timbslr/8-Bit-Breadboard-Computer/README.md

All the information and documentation about this project is currently provided via [GitHub Pages](https://timbslr.github.io/8-Bit-Breadboard-Computer/). A Readme file will be created when the project is finished.

Image of the 8-Bit Breadboard Computer from the side
