timbslr/8-Bit-Breadboard-Computer/docs/hardware-overview.md

---
title: Hardware Overview
layout: default
nav_order: 3
---

7-Segment Display schematic
