timbslr/8-Bit-Breadboard-Computer/docs/pages/hardware-overview.md

---
title: Hardware Overview
layout: default
permalink: /hardware-overview
nav_order: 3
---

## Hardware Overview

<br>

7-Segment Display schematic
