timbslr/8-Bit-Breadboard-Computer/docs/pages/modules/serial-interface.md

---
title: Serial Interface
layout: default
nav_order: 15
permalink: /modules/serial-interface
parent: Modules
---

<script type="module" src="{{ site.baseurl }}/dist/PartList.js"></script>

## Serial Interface

<part-list src="{{ site.baseurl }}/resources/PartLists/Serial Interface.csv"></part-list>

### Schematic &ndash; Receiver

<br>
Serial Interface Receiver schematic

<br>
<br>
<br>
### Schematic &ndash; Transmitter

<br>
Serial Interface Transmitter schematic
