timbslr/8-Bit-Breadboard-Computer/docs/pages/modules/memory.md

---
title: Memory
layout: default
nav_order: 12
permalink: /modules/memory
parent: Modules
---

<script type="module" src="{{ site.baseurl }}/dist/PartList.js"></script>

## Memory

<br>
<part-list src="{{ site.baseurl }}/resources/PartLists/Memory.csv"></part-list>
<br>

### Schematic

Memory schematic
