timbslr/8-Bit-Breadboard-Computer/docs/pages/modules/program-counter.md

---
title: Program Counter (PC)
layout: default
nav_order: 13
permalink: /modules/program-counter
parent: Modules
---

<script type="module" src="{{ site.baseurl }}/dist/PartList.js"></script>

## Program Counter (PC)

The Program Counter is a 16-bit register that holds the address for the next instruction. <br>
Every time an opcode or operand is fetched, the program counter is incremented in order to reference the next opcode or operand in memory.

It is also possible to load the program counter with values from the bus, which allows jumps (direct or conditional) to other memory locations.
<br>
<part-list src="{{ site.baseurl }}/resources/PartLists/PC.csv"></part-list>
<br>

### Schematic

Program-Counter schematic
