timbslr/8-Bit-Breadboard-Computer/Schematics/Reset.pdf

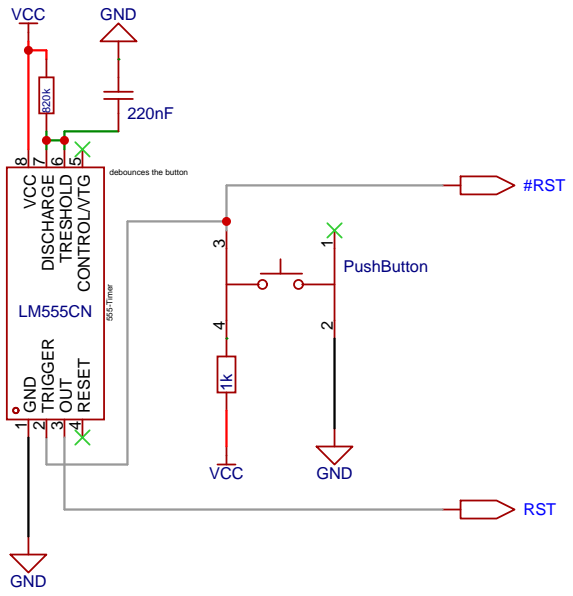
[picture p1: figure]
PushButton; VCC; GND; #RST; TRIGGER; OUT; RESET; 4 CONTROL/VTG; 5 TRESHOLD; 6 DISCHARGE; 7 VCC; GND ⁸²⁰k; 555-Timer; RST; debounces the button
