timbslr/8-Bit-Breadboard-Computer/Schematics/Y-Register.pdf

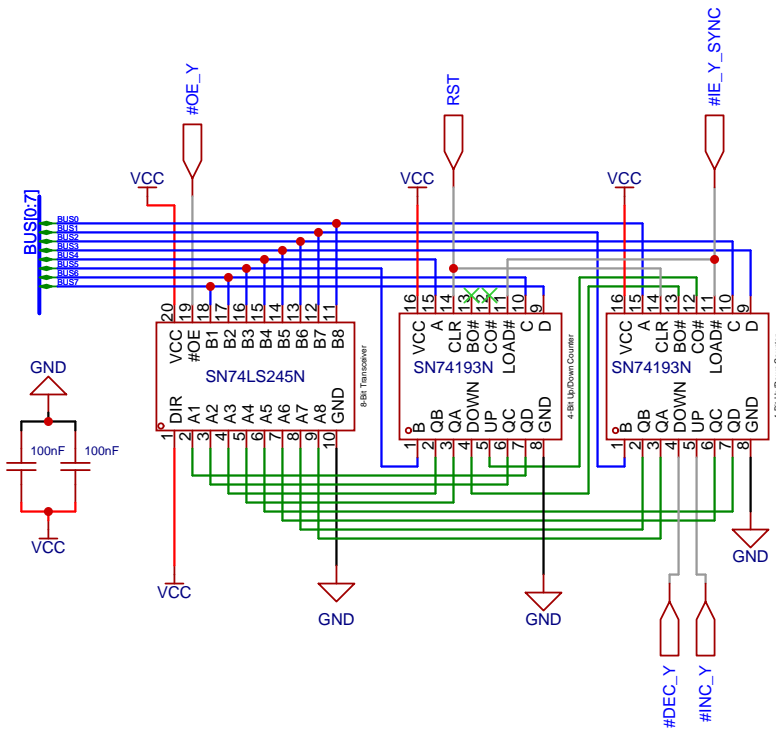
[picture p2: figure]
DIR; VCC; BUS[0:7]; GND; 8-Bit Transceiver; BUS0 BUS1 BUS2; BUS4 BUS5 BUS6 BUS7; DOWN; C 10 LOAD# 11 CO# 12 BO# 13 CLR 14; A 15 VCC 16; 4-Bit Up/Down Counter; RST; BUS3; #DEC_Y; #INC_Y #IE_Y_SYNC

GND 10 B8 11 B7 12 B6 13 B5 14 B4 15 B3 16 B2 17 B1 18 #OE 19 VCC 20

### 4-Bit Up/Down Counter
