timbslr/8-Bit-Breadboard-Computer/Schematics/Clock.pdf

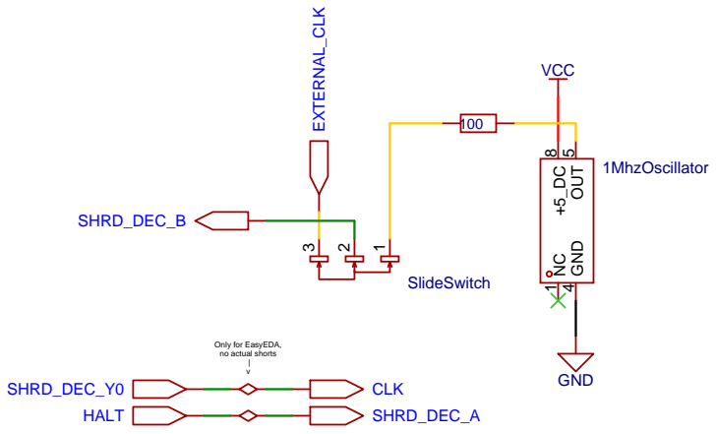
[picture p3: figure]
SHRD_DEC_A; SHRD_DEC_B; SHRD_DEC_Y0; SlideSwitch; EXTERNAL_CLK; GND; 4 OUT; 1MhzOscillator; VCC; HALT; CLK; Only for EasyEDA, no actual shorts | v
