timbslr/8-Bit-Breadboard-Computer/Schematics/LCD.pdf

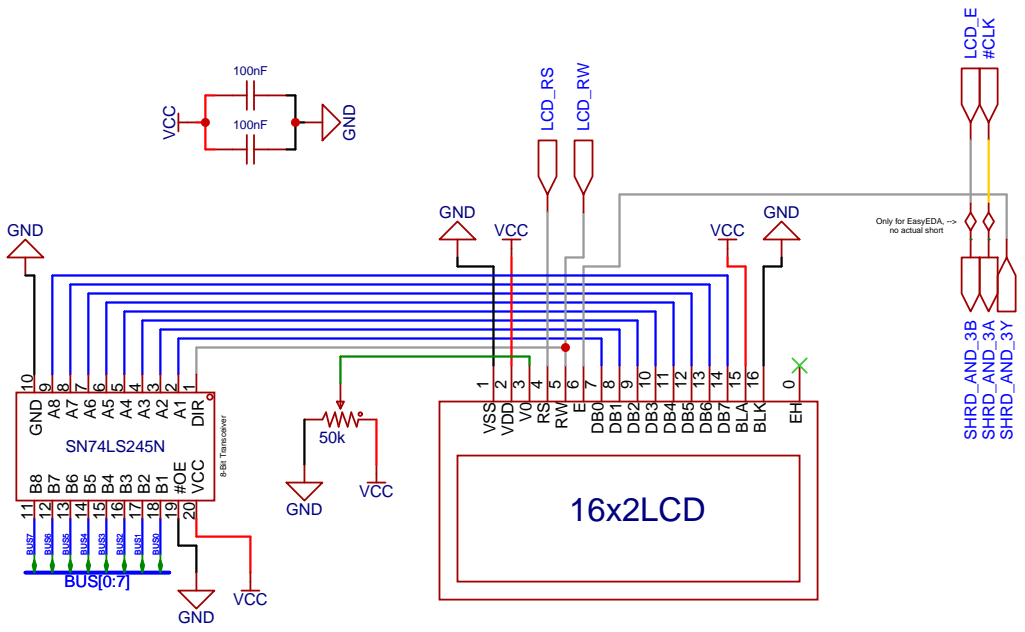
[picture p4: figure]
3 VDD; 2 VSS; 16x2LCD; VCC; GND; GND LCD_RS; LCD_RW; LCD_E #CLK; 8-Bit Transceiver; BUS[0:7]; BUS7; BUS6; BUS5; BUS4; BUS3; BUS2; BUS1; BUS0; GNDDIR; 9 GND 10 B8 11 B7 12; VCC 20; SHRD_AND_3B; SHRD_AND_3A; SHRD_AND_3Y; Only for EasyEDA, --> no actual short

BLK 16 BLA 15 DB7 14 DB6 13 DB5 12 DB4 11 DB3 10 DB2
