timbslr/8-Bit-Breadboard-Computer/docs/control-bits.md

---
title: Control Bits
layout: default
nav_order: 5
---

Each module (Registers, ALU, memory, ...) has multiple input bits that control the function of the module: Whether it loads data from the bus, outputs data to the bus, resets the module, which operation it should compute, etc. The name, abbreviation in the schematic and the description of each control bit is listed in the following table:

{: .note }
s stands for synchronous, a for asynchronous

{: #template-table}

| Abbreviation | Name | s/a | Description |
| :--- | :--- | :---: | :--- |
| Loading... | Loading... | Loading... | Loading...  |

<script type="module" src="./scripts/loadControlBits.js">
