timbslr/8-Bit-Breadboard-Computer/docs/pages/modules/a-register.md

---
title: A-Register
layout: default
nav_order: 2
permalink: /modules/a-register
parent: Modules
---

<script type="module" src="{{ site.baseurl }}/dist/PartList.js"></script>

## A-Register

The A-Register is a general-purpose 8-bit register and is built the same as the B-Register. <br>
It uses two 4-bit register chips (SN74LS173AN) and a single 8-bit bus transceiver (SN74LS245N), which controls outputting data to the bus. <br>
Technically, the 4-bit register chips even have a three-state output, so an extra 8-bit bus transceiver wouldn't be necessary. But always enabling the output of the registers and controlling the output to the bus with the bus transceiver allows me to hook up LED's to the registers output and thus displaying their contents permanently, not only on outputting to the bus. <br>

An asynchronous input provides the ability to reset the registers to zero, the CLK-input provides a synchronization for loading data from the bus (on the rising CLK edge). On the other hand, outputting data from the register to the bus is asynchronous, as the bus transceiver outputs data immediately after it's Output Enable signal goes low. <br>

The A-Register's specialty is that it is the first operand of the ALU, which means whenever you want to computer something with the ALU, no matter if it's a unary or binary operation, you have to store the first operands value in this register.

{: .warning}
Be careful when storing values into the A-Register as its contents may be overwritten by some instructions. If you store values here, ensure they aren’t overwritten unexpectedly, or store them in the safe B-, C-, X- or Y-Register.
<br>
<part-list src="{{ site.baseurl }}/resources/PartLists/A-Register.csv"></part-list>

### Schematic

<br>
A-Register schematic
