timbslr/8-Bit-Breadboard-Computer/docs/modules/clock.md

---
title: Clock
layout: default
nav_order: 6
parent: Modules
---

<script type="module" src="../scripts/PartsList.js"></script>

## Clock

<br>
<parts-list src="../resources/BOMs/Clock.csv"></parts-list>

### Schematic

<br>
Clock schematic
