timbslr/8-Bit-Breadboard-Computer/docs/modules/controller.md

---
title: Controller
layout: default
nav_order: 7
parent: Modules
---

<script type="module" src="../scripts/PartsList.js"></script>

## Controller

<br>
<parts-list src="../resources/BOMs/Controller.csv"></parts-list>

### Schematic

<br>
Controller schematic
