timbslr/8-Bit-Breadboard-Computer/docs/modules/flags-register.md

---
title: Flags-Register
layout: default
nav_order: 8
parent: Modules
---

<script type="module" src="../scripts/PartsList.js"></script>

## Flags-Register

<br>
<parts-list src="../resources/BOMs/Flags-Register.csv"></parts-list>

### Schematic

<br>
Flags-Register schematic
