timbslr/8-Bit-Breadboard-Computer/docs/modules/liquid-crystal-display.md

---
title: Liquid-Crystal-Display (LCD)
layout: default
nav_order: 10
parent: Modules
---

<script type="module" src="../scripts/PartsList.js"></script>

## Liquid-Crystal-Display (LCD)

<br>
<parts-list src="../resources/BOMs/LCD.csv"></parts-list>
<br>

### Schematic

LCD schematic
