timbslr/8-Bit-Breadboard-Computer/docs/modules/memory.md

---
title: Memory
layout: default
nav_order: 11
parent: Modules
---

<script type="module" src="../scripts/PartsList.js"></script>

## Memory

<br>
<parts-list src="../resources/BOMs/Memory.csv"></parts-list>
<br>

### Schematic

Memory schematic
