timbslr/8-Bit-Breadboard-Computer/docs/pages/parts-list.md

---
title: Parts List
layout: default
permalink: /parts-list
nav_order: 7
---

<link rel="stylesheet" href="{{ site.baseurl }}/styles/switch.css">
<script type="module" src="{{ site.baseurl }}/dist/PartList.js"></script>

---

<div class="toggle-switch-container">
  <label>Show the origins of the parts</label>
  <label class="switch small">
    <input type="checkbox" id="toggle-switch" checked>
    <span class="slider round"></span>
  </label>
</div>

---

<part-list src="ALL"></part-list>

<script>
  const checkbox = document.getElementById("toggle-switch");

  checkbox.addEventListener("change", () => {
    const cells = document.querySelectorAll(".part-list-table-col2");
    cells.forEach(cell => {
      cell.classList.toggle("hidden", !checkbox.checked);
    });
  });
</script>

<style>
  .hidden {
    display: none;
  }

  .toggle-switch-container {
    display: flex;
    justify-content: space-between;
  }

  .main-content ul > li::before {
    content: "▹";
  }
</style>
