timbslr/8-Bit-Breadboard-Computer/docs/resources/PartLists/SP.csv

Quantity | Name
2 | 5.1kΩ Resistor
1 | 74LS123 (Dual Monostable Mulivibrator)
2 | 74LS245 (8-Bit Transceiver)
2 | 82pF Capacitor
2 | 100nF Capacitor
4 | 74193 (4-Bit Up/Down Counter)
