timbslr/8-Bit-Breadboard-Computer/docs/resources/PartLists/General.csv

Quantity | Name
14 | Breadboard
2 | 4x LED Label Plate
12 | 8x LED Label Plate
1 | 16x LED Label Plate
56 | Red LED
50 | Green LED
8 | Yellow LED
8 | Blue LED
64 | 470Ω Resistor
50 | 2.2kΩ Resistor
8 | 680Ω Resistor
1 | 28x ZIF-Socket
8 | 1kΩ Resistor
70 | Meters of 22AWG Wire (approx.)
