timbslr/8-Bit-Breadboard-Computer/docs/resources/PartLists/Controller.csv

Quantity | Name
10 | 1kΩ Resistor
1 | 2.7kΩ Resistor
4 | 28C64 (8KiB EEPROM)
1 | 74LS32 (Quad 2-Input OR)
1 | 74LS86 (Quad 2-Input XOR)
1 | 74LS161 (4-Bit Binary Counter)
1 | 74LS173 (4-Bit Register)
2 | 100nF Capacitor
12 | 100pF Capacitor
1 | 330Ω Resistor
1 | 74138 (8 Line Decoder)
1 | 74151 (8-Line Multiplexer)
2 | 74154 (16-Line Decoder)
