timbslr/8-Bit-Breadboard-Computer/docs/resources/PartLists/Reset.csv

Quantity | Name
1 | 1kΩ Resistor
1 | 220nF Capacitor
1 | 820kΩ Resistor
1 | LM555CN (555-Timer)
1 | Push Button
