timbslr/8-Bit-Breadboard-Computer/docs/resources/PartLists/X-Register.csv

Quantity | Name
2 | 5.1kΩ Resistor
1 | 74LS123 (Dual Monostable Mulivibrator)
1 | 74LS245 (8-Bit Transceiver)
2 | 82pF Capacitor
2 | 100nF Capacitor
2 | 74193 (4-Bit Up/Down Counter)
