timbslr/8-Bit-Breadboard-Computer/docs/resources/PartLists/Y-Register.csv

Quantity | Name
1 | 74LS245 (8-Bit Transceiver)
2 | 100nF Capacitor
2 | 74193 (4-Bit Up/Down Counter)
