timbslr/8-Bit-Breadboard-Computer/docs/resources/PartLists/Serial Interface.csv

Quantity | Name
2 | 1N4148 Diode
2 | 1nF Capacitor
1 | 6.8kΩ Resistor
3 | 10kΩ Resistor
1 | 12kΩ Resistor
1 | 15kΩ Resistor
1 | 74LS02 (Quad 2-Input NOR)
1 | 74LS04 (Hex NOT-Gate)
1 | 74LS08 (Quad 2-Input AND)
1 | 74LS32 (Quad 2-Input OR)
1 | 74LS123 (Dual Monostable Mulivibrator)
1 | 74LS161 (4-Bit Binary Counter)
1 | 74LS164 (8-Bit SIPO Shift-Register)
1 | 74LS173 (4-Bit Register)
1 | 74LS245 (8-Bit Transceiver)
6 | 100nF Capacitor
1 | 100pF Capacitor
1 | 7474 (Dual D-Flip-Flops)
1 | 74153 (Dual 4-Input Multiplexer)
1 | 74165 (8-Bit PISO Shift-Register)
2 | LM555CN (555-Timer)
