timbslr/8-Bit-Breadboard-Computer/docs/resources/PartLists/7-Segment Display.csv

Quantity | Name
1 | 1kΩ Resistor
3 | 10nF Capacitor
1 | 28C16 (2KiB EEPROM)
1 | 74LS107 (Dual JK-Flip-Flop)
1 | 74LS139 (Dual 2 to 4 Line Decoder)
2 | 74LS173 (4-Bit Register)
1 | 100kΩ Resistor
2 | 100nF Capacitor
1 | KYX-5461AS (4x7-Segment Display)
2 | LM555CN (555-Timer)
