timbslr/8-Bit-Breadboard-Computer/docs/resources/PartLists/Clock.csv

Quantity | Name
1 | 1Mhz Oscillator
1 | 3-Pin Slide Switch
1 | 100Ω Resistor
