timbslr/8-Bit-Breadboard-Computer/docs/resources/PartLists/ALU.csv

Quantity | Name
2 | 28C16 (2KiB EEPROM)
1 | 74LS00 (Quad 2-Input NAND)
1 | 74LS02 (Quad 2-Input NOR)
1 | 74LS08 (Quad 2-Input AND)
2 | 74LS86 (Quad 2-Input XOR)
4 | 74LS157 (Quad 2-Line Multiplexer)
1 | 74LS245 (8-Bit Transceiver)
2 | 74LS283 (4-Bit Adder)
2 | 100nF Capacitor
