timbslr/8-Bit-Breadboard-Computer/docs/resources/PartLists/C-Register.csv

Quantity | Name
2 | 74LS173 (4-Bit Register)
1 | 74LS245 (8-Bit Transceiver)
2 | 100nF Capacitor
