timbslr/8-Bit-Breadboard-Computer/docs/resources/PartLists/LCD.csv

Quantity | Name
1 | 16x2 LCD
1 | 50kΩ Potentiometer
1 | 74LS245 (8-Bit Transceiver)
2 | 100nF Capacitor
