timbslr/8-Bit-Breadboard-Computer/docs/resources/PartLists/Memory.csv

Quantity | Name
1 | 28C256 (32KiB EEPROM)
1 | 74LS04 (Hex NOT-Gate)
1 | 74LS245 (8-Bit Transceiver)
2 | 100nF Capacitor
1 | U62256 (32KiB SRAM)
