timbslr/8-Bit-Breadboard-Computer/docs/resources/PartLists/PC.csv

Quantity | Name
4 | 74LS161 (4-Bit Binary Counter)
2 | 74LS245 (8-Bit Transceiver)
2 | 100nF Capacitor
