timbslr/8-Bit-Breadboard-Computer/docs/resources/PartLists/Flags-Register.csv

Quantity | Name
1 | 74LS173 (4-Bit Register)
2 | 100nF Capacitor
1 | 74126 (4-Bit Bus Buffer)
