timbslr/8-Bit-Breadboard-Computer/docs/resources/PartLists/MAR.csv

Quantity | Name
4 | 74LS173 (4-Bit Register)
2 | 100nF Capacitor
