timbslr/8-Bit-Breadboard-Computer/docs/parts-list.md

---
title: Parts List
layout: default
nav_order: 6
---

<script type="module" src="./scripts/PartsList.js"></script>

Here is a complete list of all the parts needed for building this project:

<parts-list src="ALL"></parts-list>
