timbslr/8-Bit-Breadboard-Computer/docs/pages/instruction-set/details.md

---
title: Instruction Details
layout: default
permalink: /instruction-set/details
nav_exclude: true
---

:point_right: Click to switch representation:

[Instruction Set Overview](./overview){: .btn .btn-outline}
[Opcode Matrix](./opcode-matrix){: .btn .btn-outline}
[Instruction Details](./details){: .btn .btn-green}

---

<style>
  .header {
    font-weight: 800;
  }

  .description {
    color: #646464;
  }

  .highlightedHeader {
    display: inline;
    background-color: yellow;
    transition: background-color 0.5s ease-out;
  }

  h1, h2, h3, h4, h5, h6 {
    display: inline;
    transition: background-color 0.5s ease-out;
  }
</style>

<script type="module" src="{{ site.baseurl }}/dist/PageLoader/loadInstructionDetails.js">
