timbslr/8-Bit-Breadboard-Computer/docs/instruction-set/details.md

---
title: Instruction Details
layout: default
nav_exclude: true
---

:point_right: Click to switch representation:

[Instruction Set Overview](./overview.html){: .btn .btn-outline}
[OpCode Matrix](./opcode-matrix.html){: .btn .btn-outline}
[Instruction Details](./details.html){: .btn .btn-green}

---

{: #template-stats-table}

| Instruction Type | Group | Opcode | Clobbered Registers | Size in ROM | Number of Clock Cycles |
| :---: | :---: | :---: | :---: | :---: | :---: |
| Loading... | Loading... | Loading... | Loading... | Loading...  | Loading... |

<style>
  .highlightedHeader {
    display: inline;
    background-color: yellow;
    transition: background-color 0.5s ease-out;
  }

  h1, h2, h3, h4, h5, h6 {
    display: inline;
    transition: background-color 0.5s ease-out;
  }
</style>

<script type="module" src="../scripts/loadInstructionDetails.js">
