timbslr/8-Bit-Breadboard-Computer/docs/pages/key-characteristics.md

---
title: Key Characteristics
layout: default
permalink: /key-characteristics
nav_order: 2
---

<script type="module" src="{{ site.baseurl }}/dist/PageLoader/loadKeyCharacteristics.js"></script>

## Key Characteristics

<div id="outer-container">
  <div id="inner-container">
    <table> 
      <tbody> 
        <tr> <td>CPU Type</td> <td>Multi-Cycle Processor</td> </tr>
        <tr> <td>Architecture</td> <td>Von-Neumann</td> </tr>
        <tr> <td>Frequency</td> <td>1MHz</td> </tr>
        <tr> <td>Endianness</td> <td>Little Endian</td> </tr>
        <tr> <td>Opcode Size</td> <td>8 Bit</td> </tr>
        <tr> <td></td> <td></td> </tr>
        <tr> <td>Amount of Instructions</td> <td id="amount-of-instructions">Loading...</td> </tr>
        <tr> <td>&empty;CPI</td> <td id="average-cpi">Loading...</td> </tr>
        <tr> <td></td> <td></td> </tr>
        <tr> <td>Data Width</td> <td>8 Bit</td> </tr>
        <tr> <td>Address Width</td> <td>16 Bit</td> </tr>
        <tr> <td>Program Counter Width</td> <td>16 Bit</td> </tr>
        <tr> <td>Stack Pointer Width</td> <td>15 Bit</td> </tr>
        <tr> <td>Bus Width</td> <td>8 Bit</td> </tr>
        <tr> <td></td> <td></td> </tr>
        <tr> <td>ALU Size</td> <td>8 Bit</td> </tr>
        <tr> <td>ALU Status Flags</td> <td><ul><li>Zero (Z)</li><li>Negative (N)</li><li>Carry (C)</li><li>Overflow (V)</li></ul></td> </tr>
        <tr> <td></td> <td></td> </tr>
        <tr> <td>ROM Size</td> <td>32 KiB</td> </tr>
        <tr> <td>ROM Type</td> <td>EEPROM</td> </tr>
        <tr> <td>RAM Size</td> <td>32 KiB</td> </tr>
        <tr> <td>RAM Type</td> <td>SRAM</td> </tr>
        <tr> <td></td> <td></td> </tr>
        <tr> <td>I/O</td> <td><ul><li>7 Segment Display</li><li>LCD</li><li>Serial Interface</li></ul></td> </tr>
        <tr> <td>Serial Baudrate</td> <td>57600</td> </tr>
        <tr> <td>Memory-Mapped I/O?</td> <td>No</td> </tr>
        <tr> <td></td> <td></td> </tr>
        <tr> <td>V<sub>CC</sub></td> <td>5V</td> </tr>
        <tr> <td>Power Consumption</td> <td>~ 800mA</td> </tr>
        <tr> <td>Logic Family</td> <td>TTL</td> </tr>
        <tr> <td></td> <td></td> </tr>
        <tr> <td>Amount of ICs</td> <td id="amount-of-ics">Loading...</td> </tr>
        <tr> <td>Amount of Breadboards</td> <td>18</td> </tr>
      </tbody>
    </table>
  </div>
</div>

<style>
  #outer-container {
    padding: 3%;
    width: 100%;
  }

  #inner-container {
    border: 1px solid black;
    border-radius: 12px;
  }

  .table-wrapper {
    border-radius: 12px;
    margin: 0 !important;
  }

  table {
    position: relative;
    z-index: -1
  }
</style>
