timbslr/8-Bit-Breadboard-Computer/Schematics/Serial Interface Transmitter.pdf

# VCC

# VCC

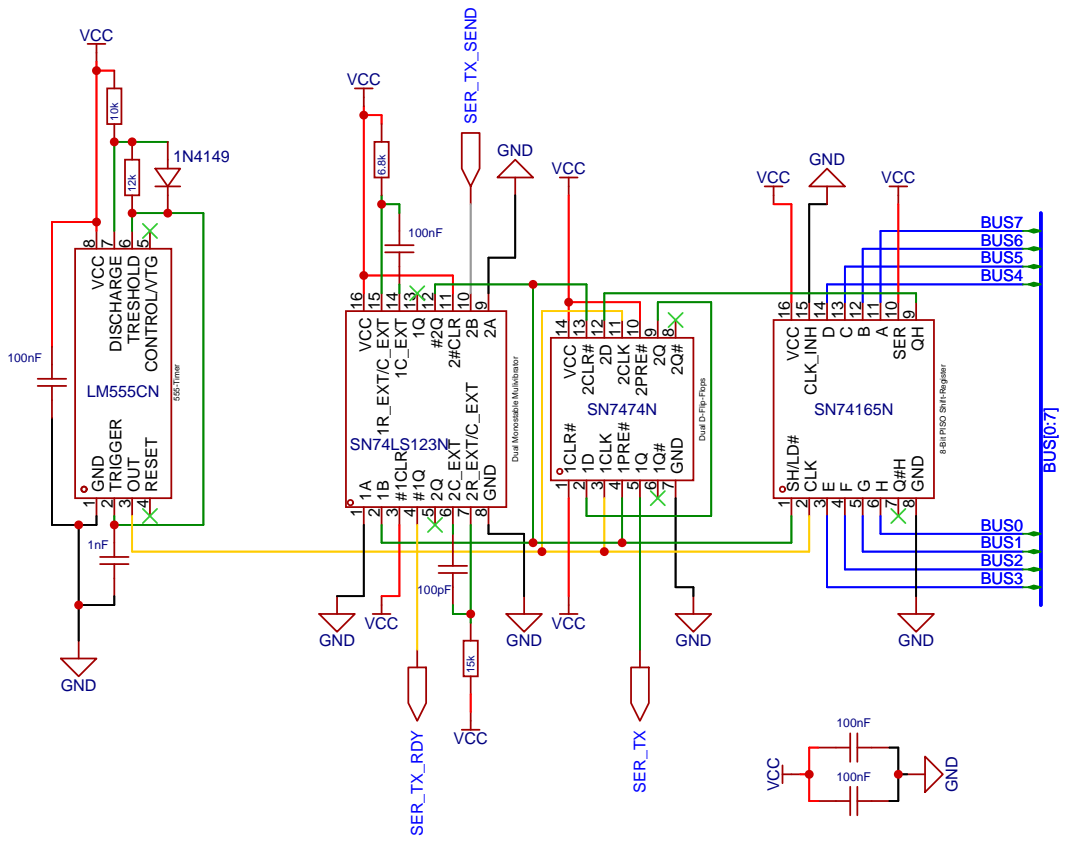
[picture p5: page 1]

RESET 4 CONTROL/VTG 5 TRESHOLD 6 DISCHARGE 7 VCC 8

GND 8 QH 9 SER 10 A 11 B 12 C 13 D 14 CLK_INH 15 VCC 16

8-Bit PISO Shift-Register
