timbslr/8-Bit-Breadboard-Computer/Schematics/SP.pdf

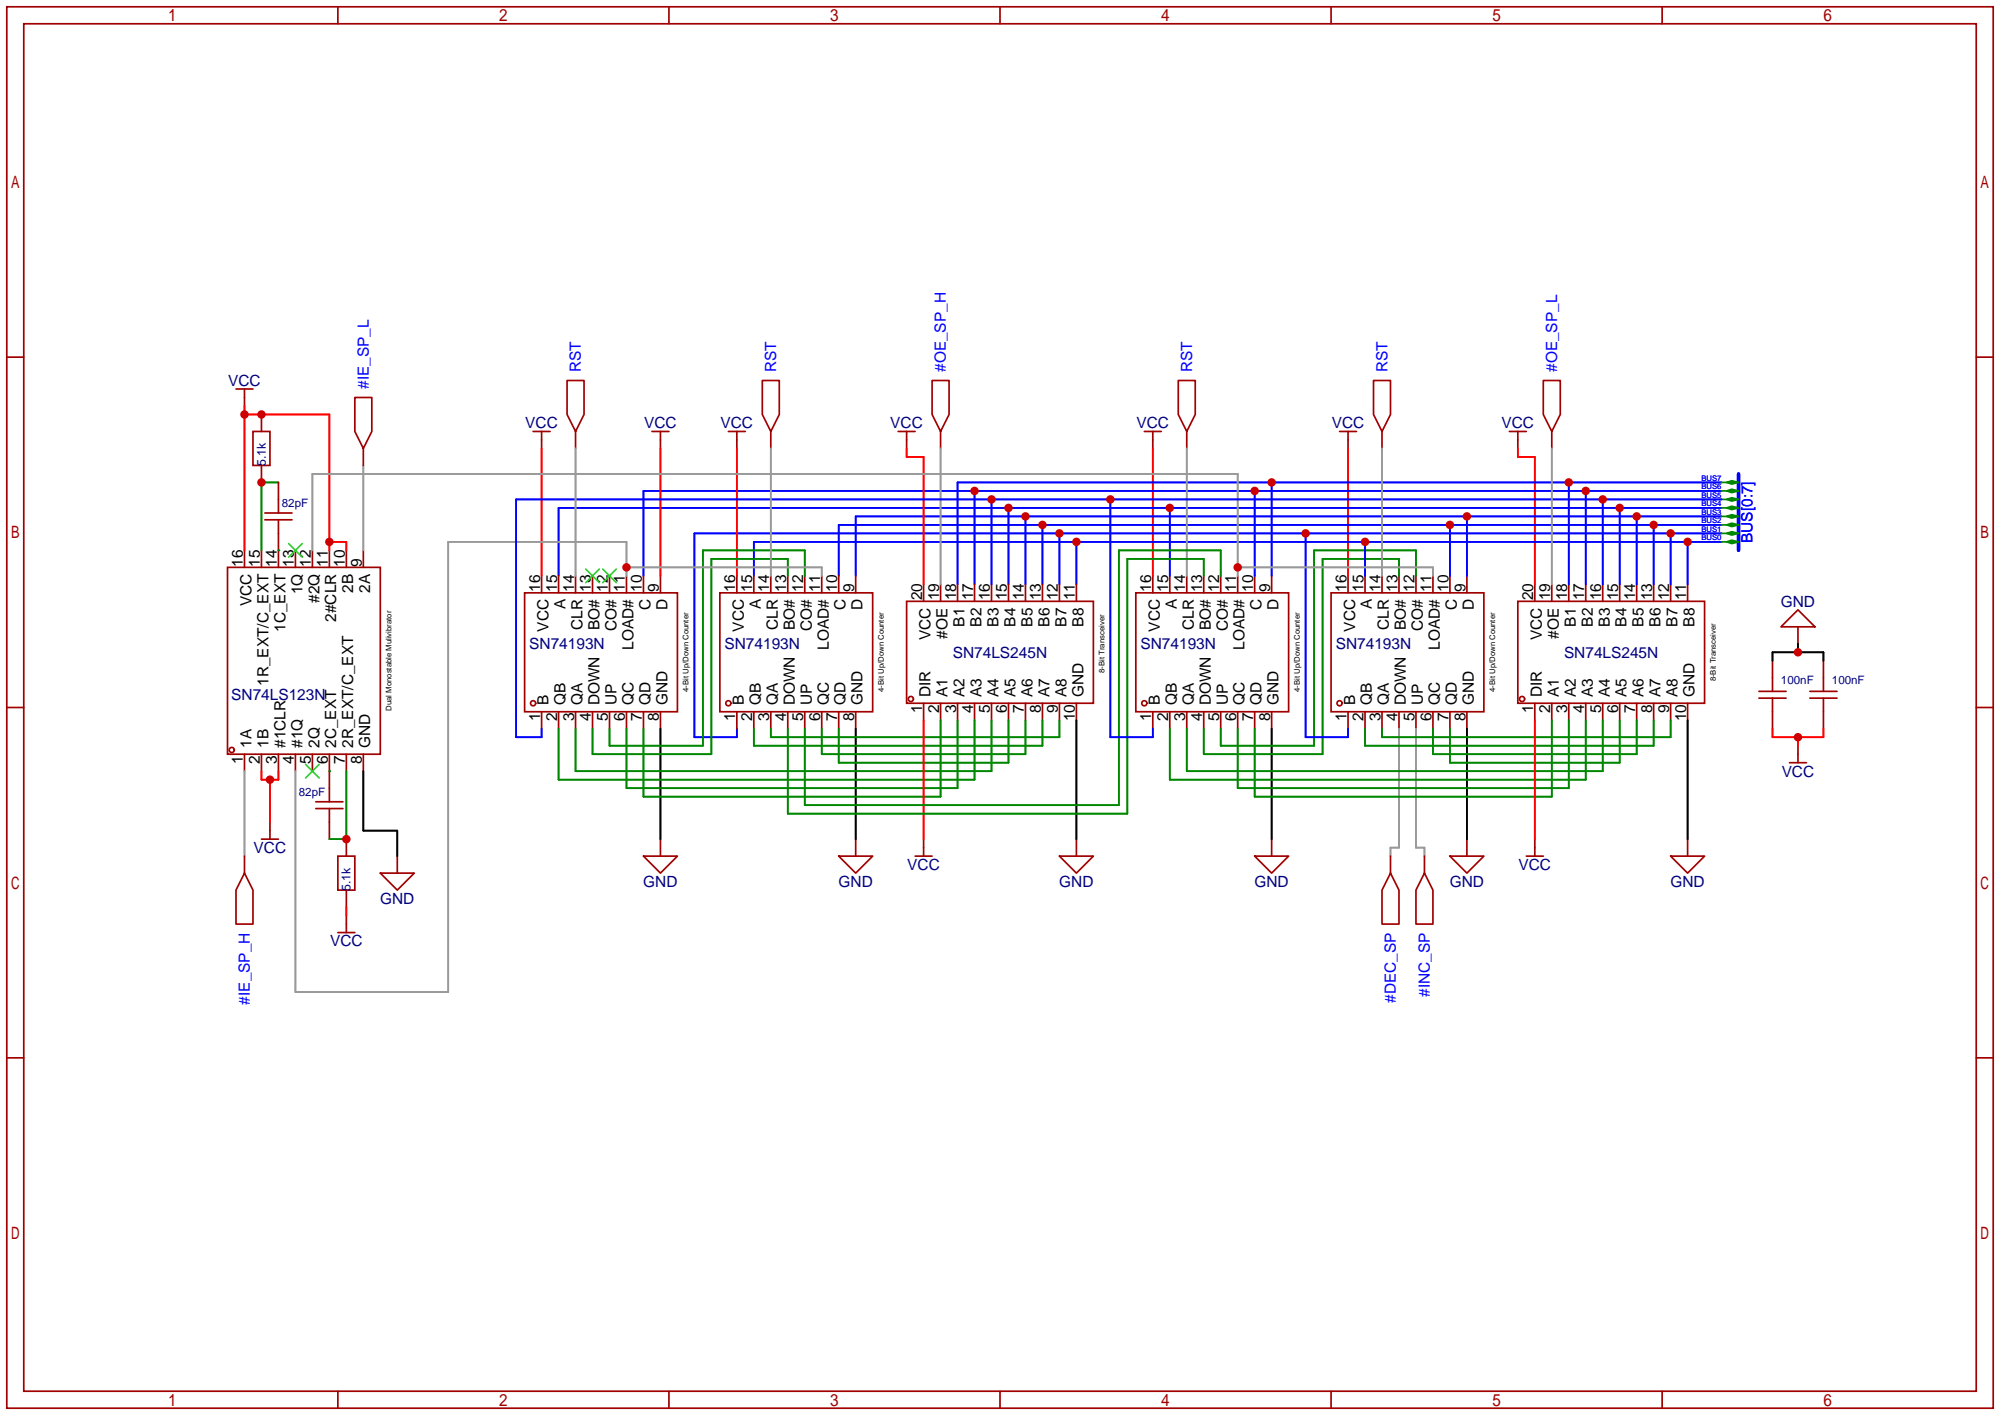
[picture p6: page 1]

C 10 LOAD# 11 CO# 12 BO# 13 CLR 14

4-Bit Up/Down Counter
