timbslr/8-Bit-Breadboard-Computer/Schematics/Overview - Microarchitecture Diagram.pdf

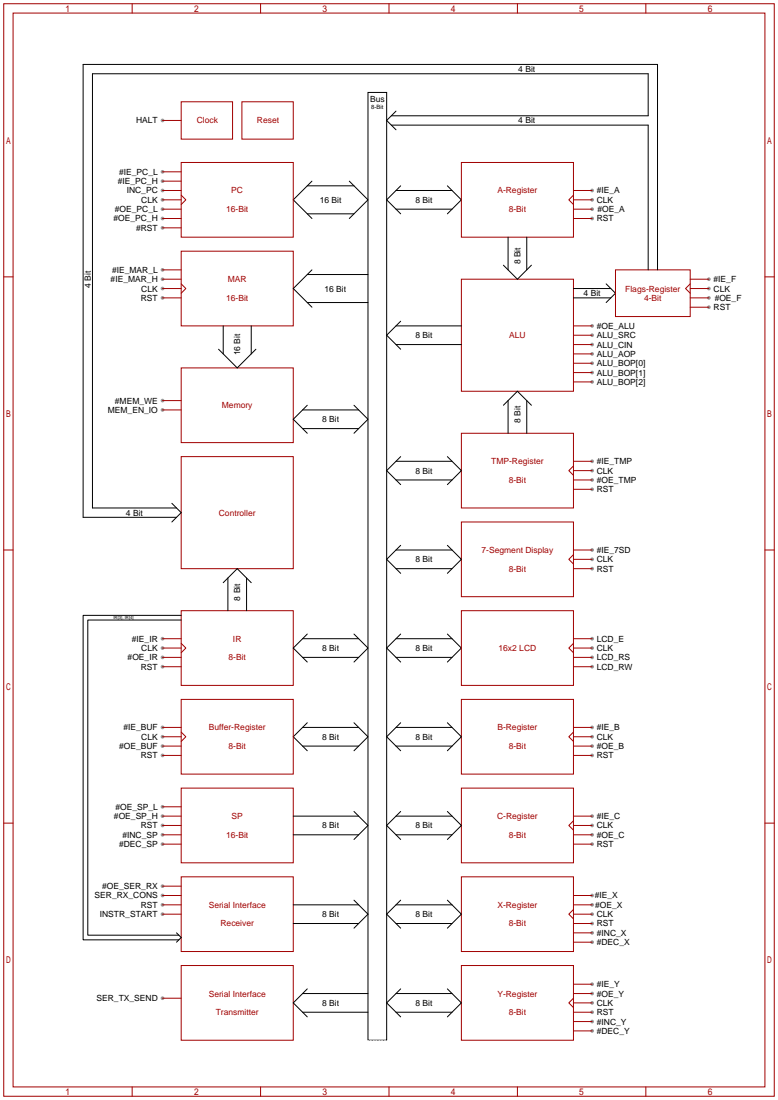
[picture p7: page 1]
