timbslr/8-Bit-Breadboard-Computer/Schematics/Controller.pdf

# OE_TMP #OE_A

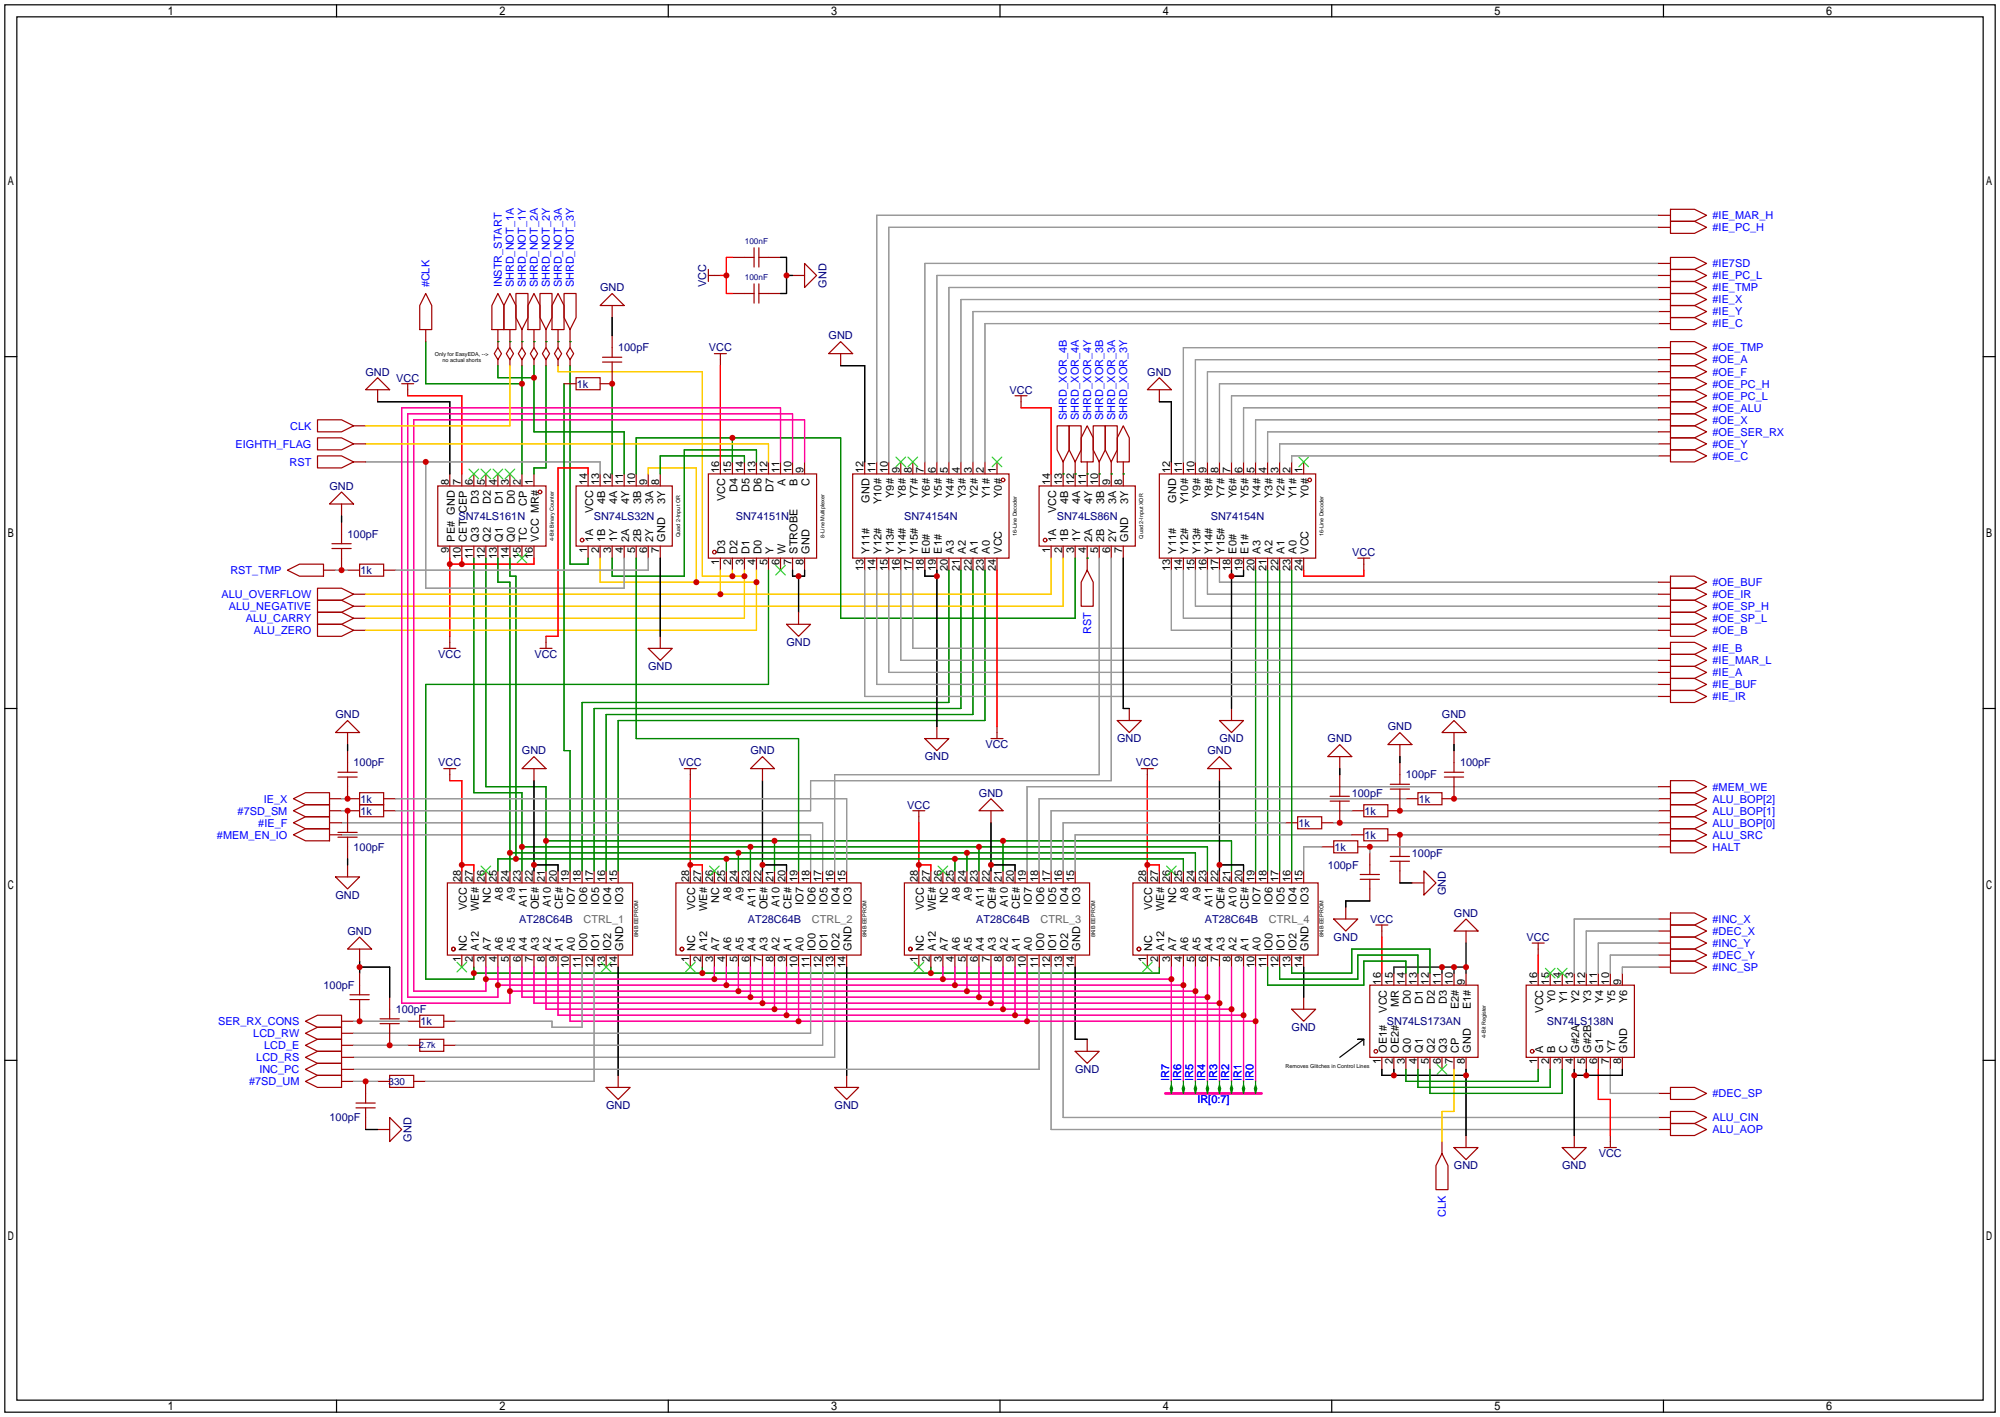
[picture p8: page 1]

Removes Glitches in Control Lines INC_PC
