timbslr/8-Bit-Breadboard-Computer/Schematics/Memory.pdf

# MAR-BUS[0:15]

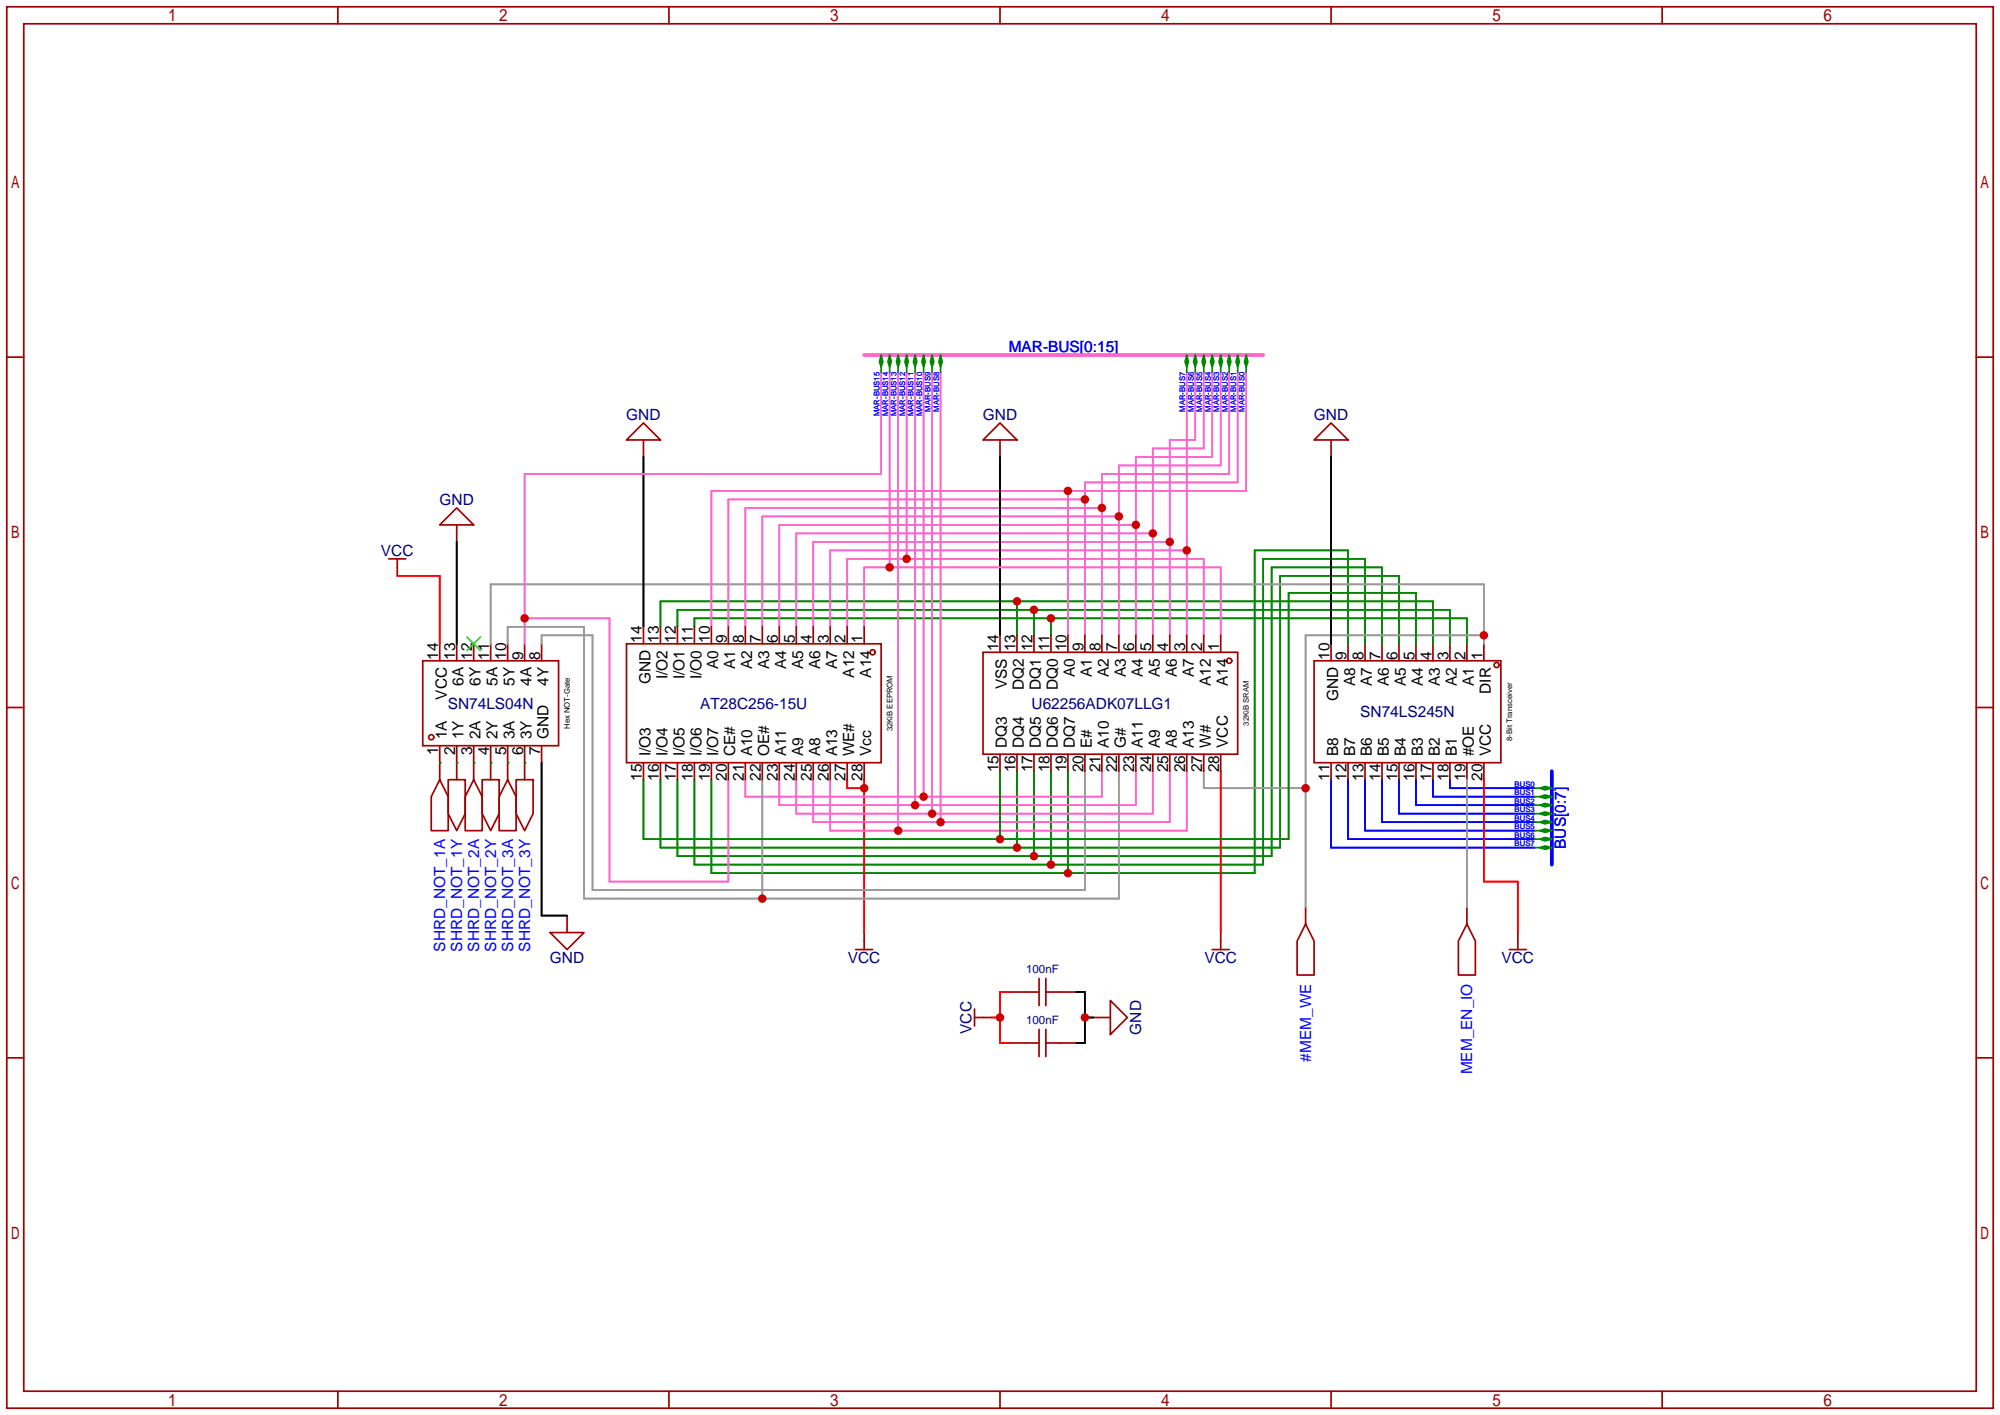
[picture p9: page 1]
