timbslr/8-Bit-Breadboard-Computer/Schematics/7 Segment Display.pdf

10nF

# VCC

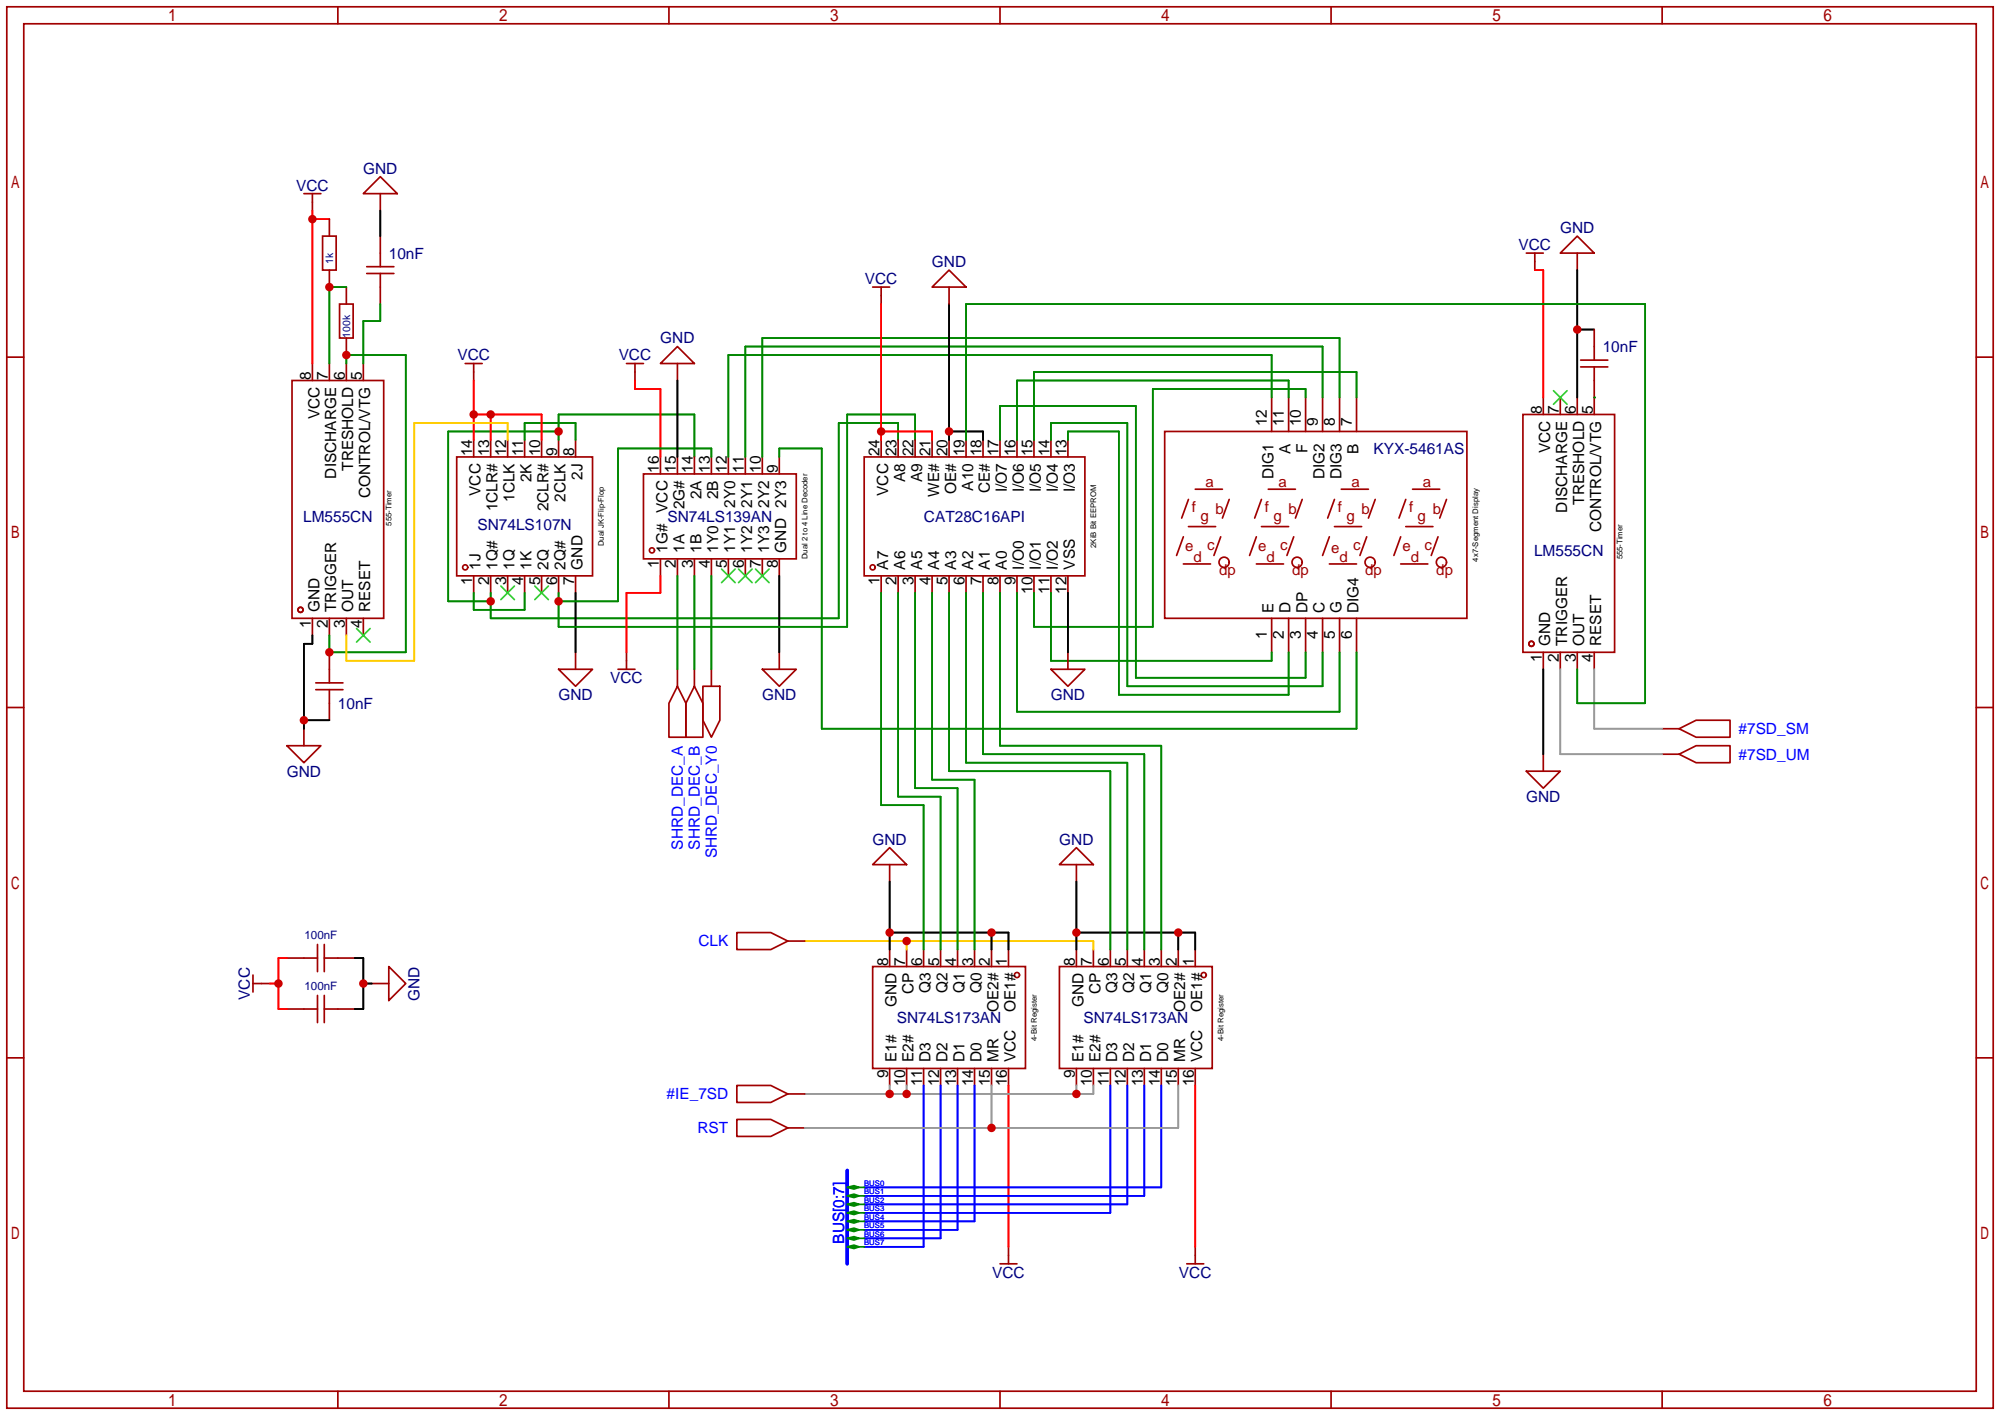
[picture p10: page 1]

VSS 12 I/O3 13 I/O4 14 I/O5 15 I/O6 16 I/O7 17 CE# 18 A10 19 OE# 20 WE# 21 A9 22 A8 23 VCC 24

Dual 2 to 4 Line Decoder

Dual JK-Flip-Flop
