timbslr/8-Bit-Breadboard-Computer/Schematics/A-Register.pdf

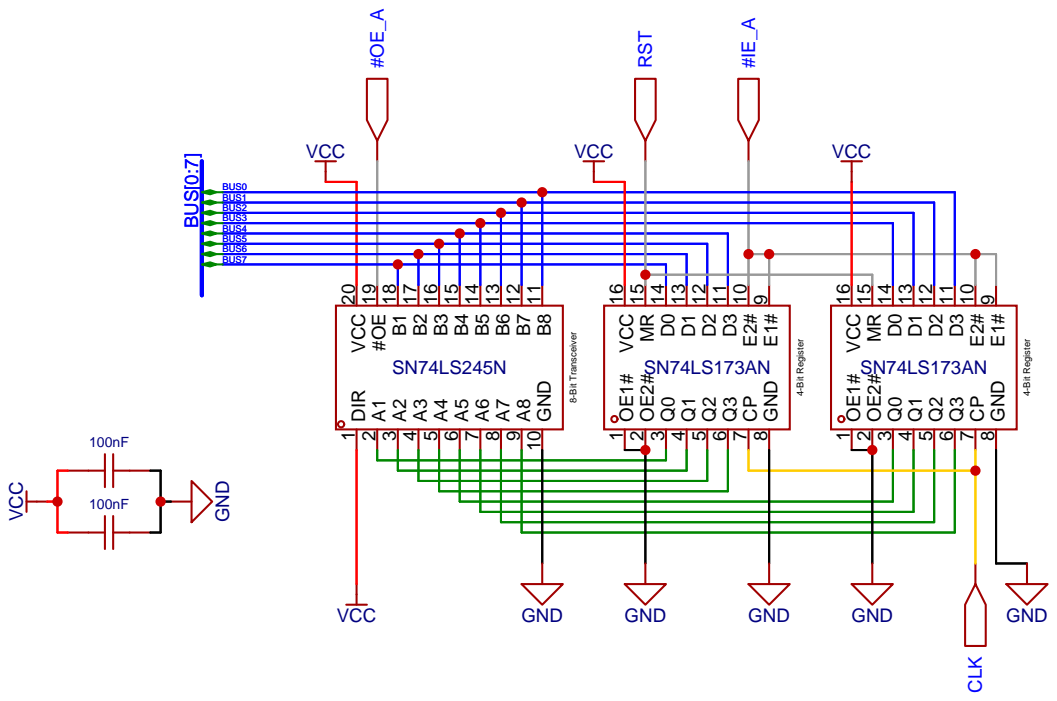
[picture p11: page 1]
