timbslr/8-Bit-Breadboard-Computer/Schematics/ALU.pdf

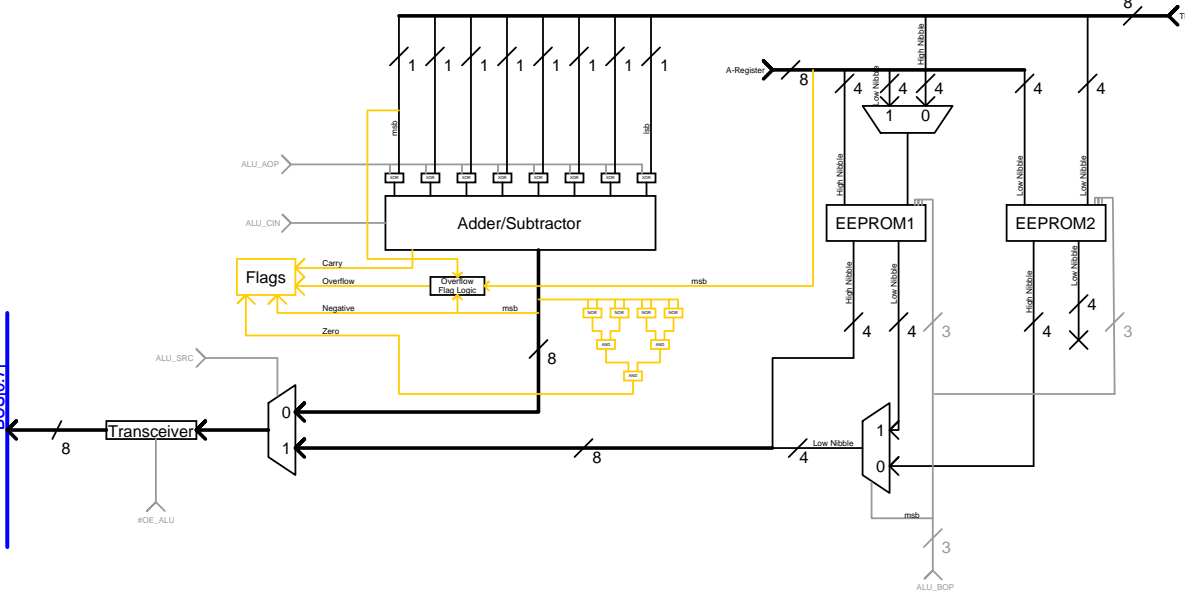
[picture p12: figure]
Transceiver; Adder/Subtractor; ALU_SRC; Flags; Carry; XOR; ALU_AOP; High Nibble; msb; lsb; Low Nibble; A-Register; NOR; AND; Zero; Negative; ALU_BOP 3; ALU_CIN; #OE_ALU; Overflow; Flag Logic

# BUS[0:7]

EEPROM1 | EEPROM2 4 | 4 High Nibble | Low Nibble | 4 High Nibble | 4Low Nibble 01

### TMP-Register

8

# SN74LS08N

# A-REGISTER[0:7]

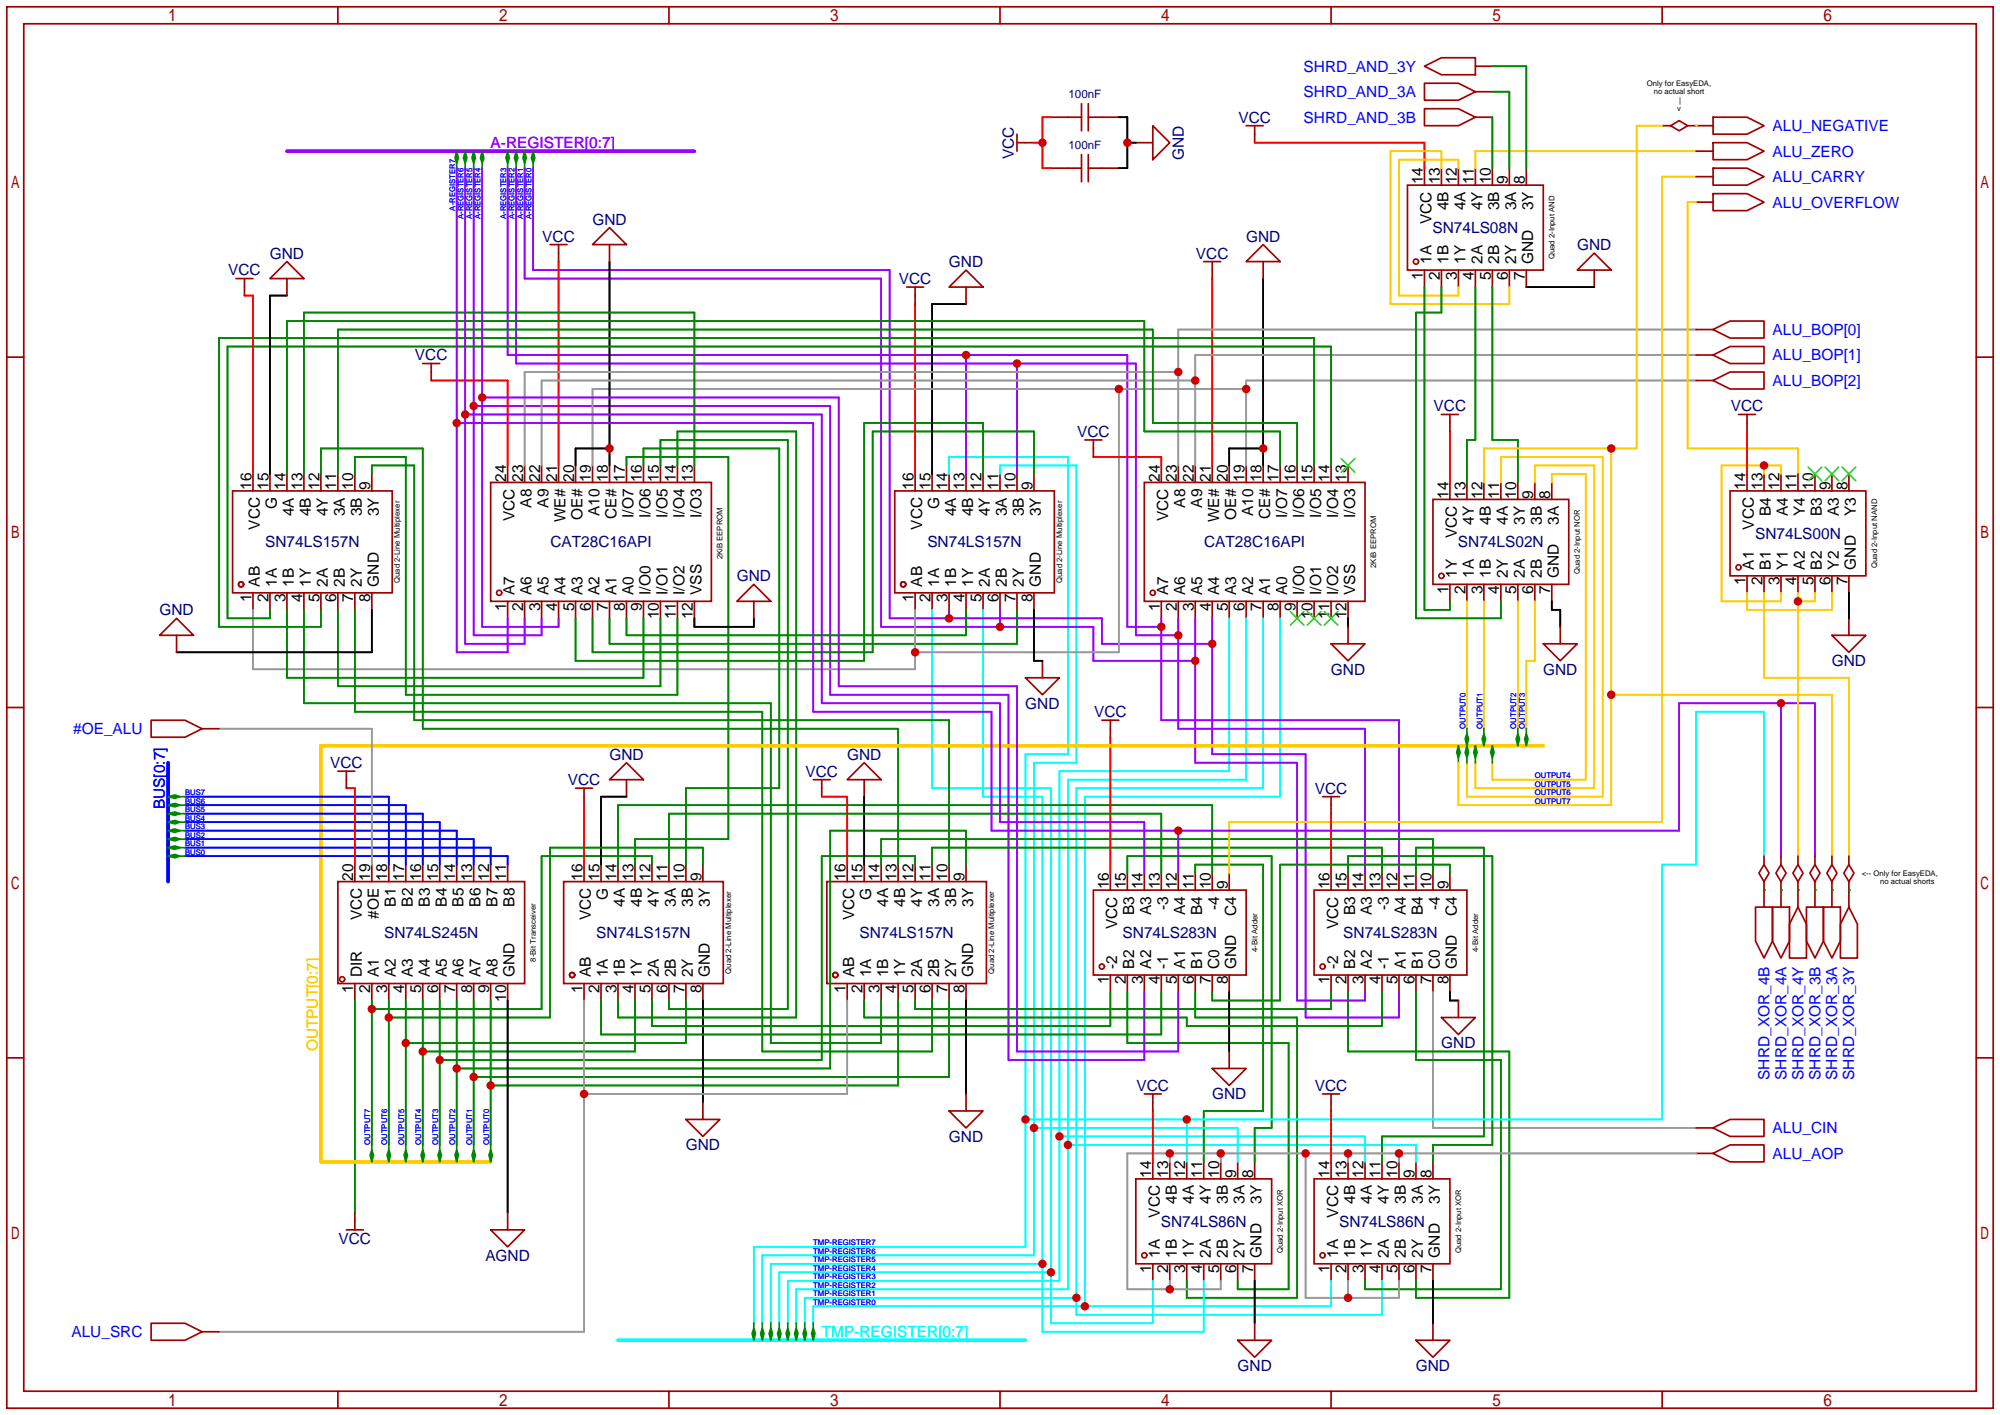
[picture p13: page 2]
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
