timbslr/8-Bit-Breadboard-Computer/Schematics/B-Register.pdf

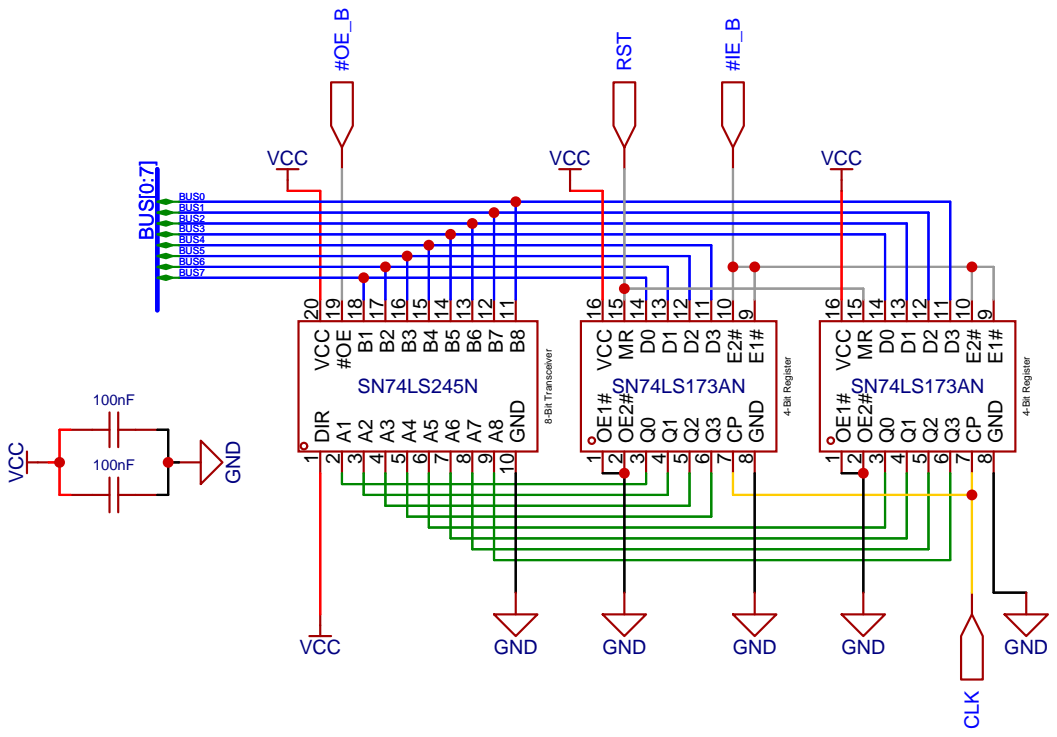
[picture p14: page 1]
