timbslr/8-Bit-Breadboard-Computer/Schematics/Buffer-Register.pdf

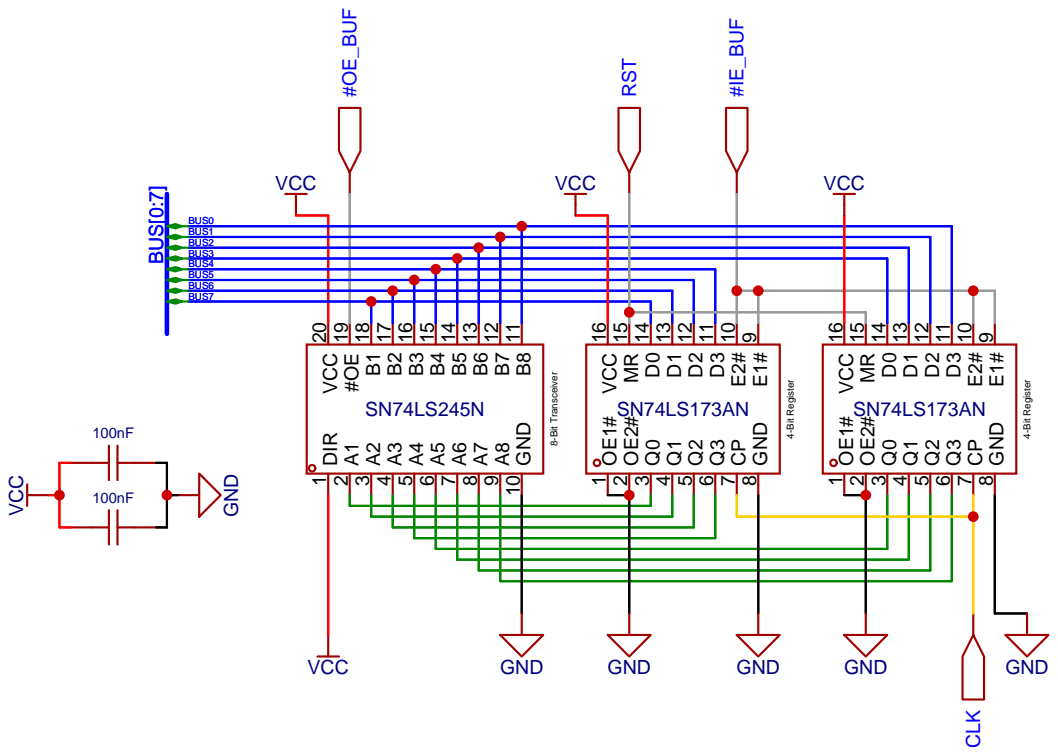
[picture p15: page 1]
