timbslr/8-Bit-Breadboard-Computer/Schematics/C-Register.pdf

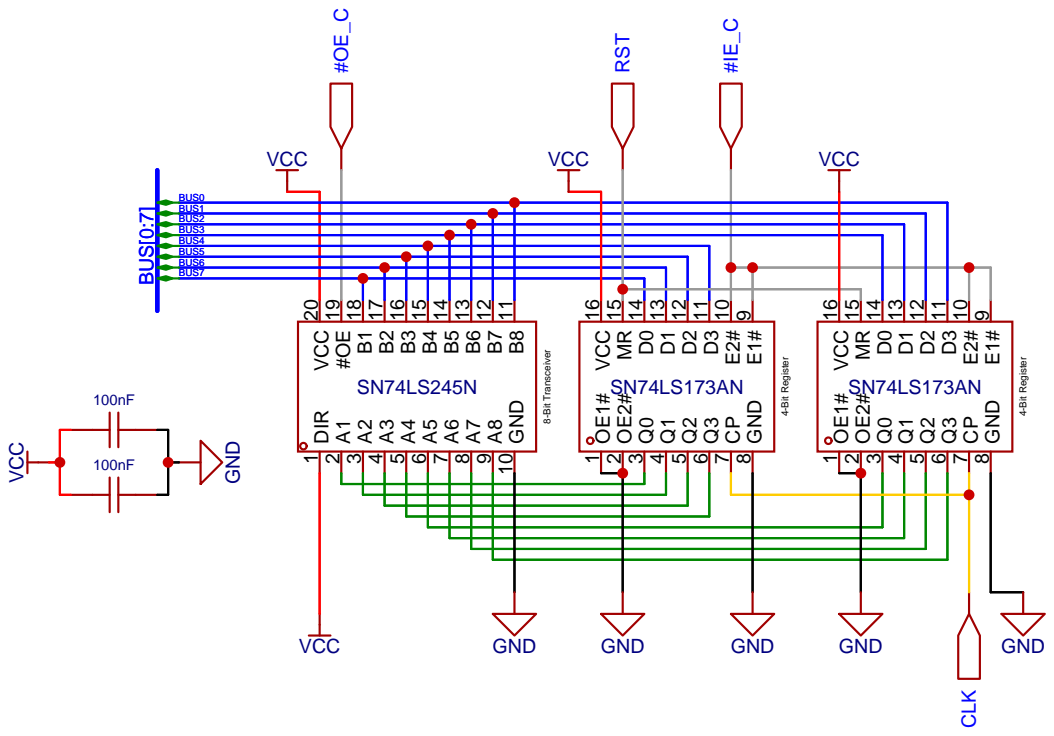
[picture p16: page 1]
