timbslr/8-Bit-Breadboard-Computer/Schematics/Flags-Register.pdf

100nF

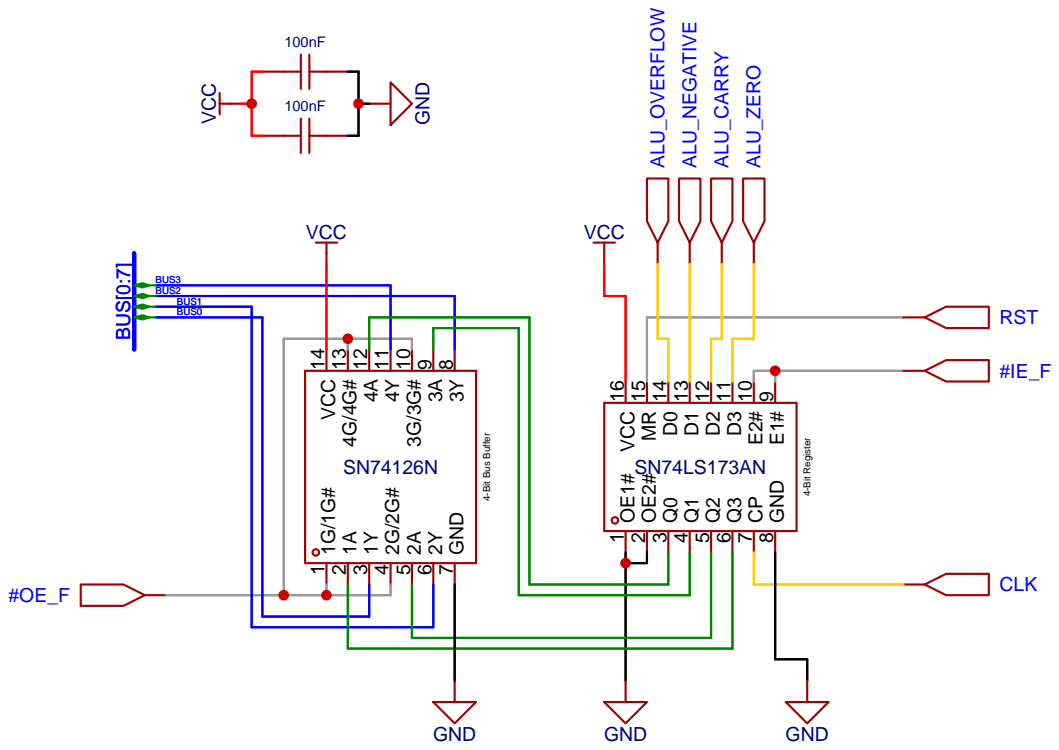
[picture p17: page 1]
