timbslr/8-Bit-Breadboard-Computer/Schematics/IR.pdf

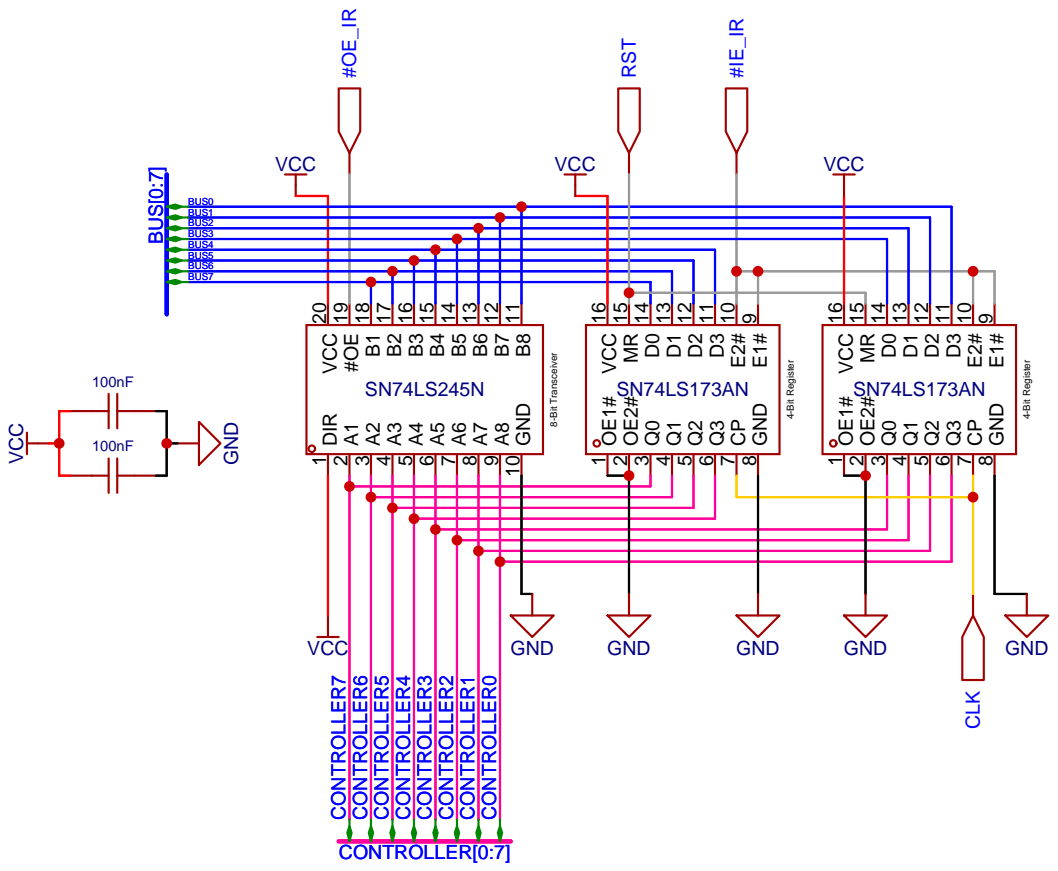
[picture p18: page 1]
