timbslr/8-Bit-Breadboard-Computer/Schematics/MAR.pdf

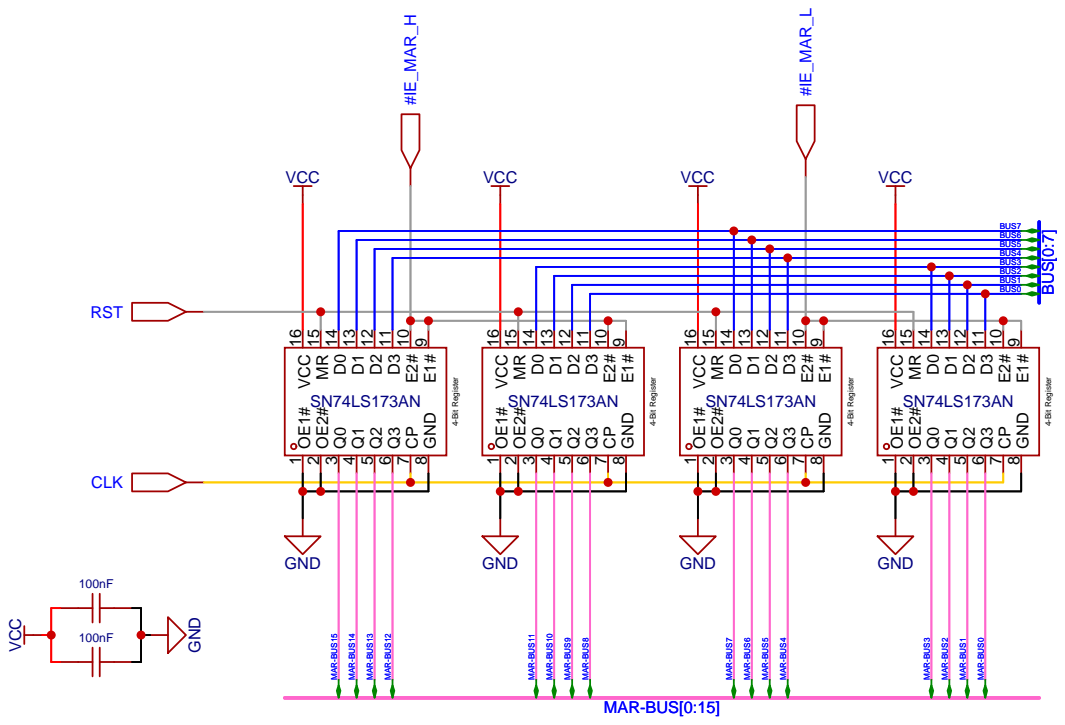
[picture p19: page 1]

BUS6
BUS5
BUS4
BUS3
BUS2
BUS1
BUS0
