timbslr/8-Bit-Breadboard-Computer/Schematics/Serial Interface Receiver.pdf

100nF

100nF

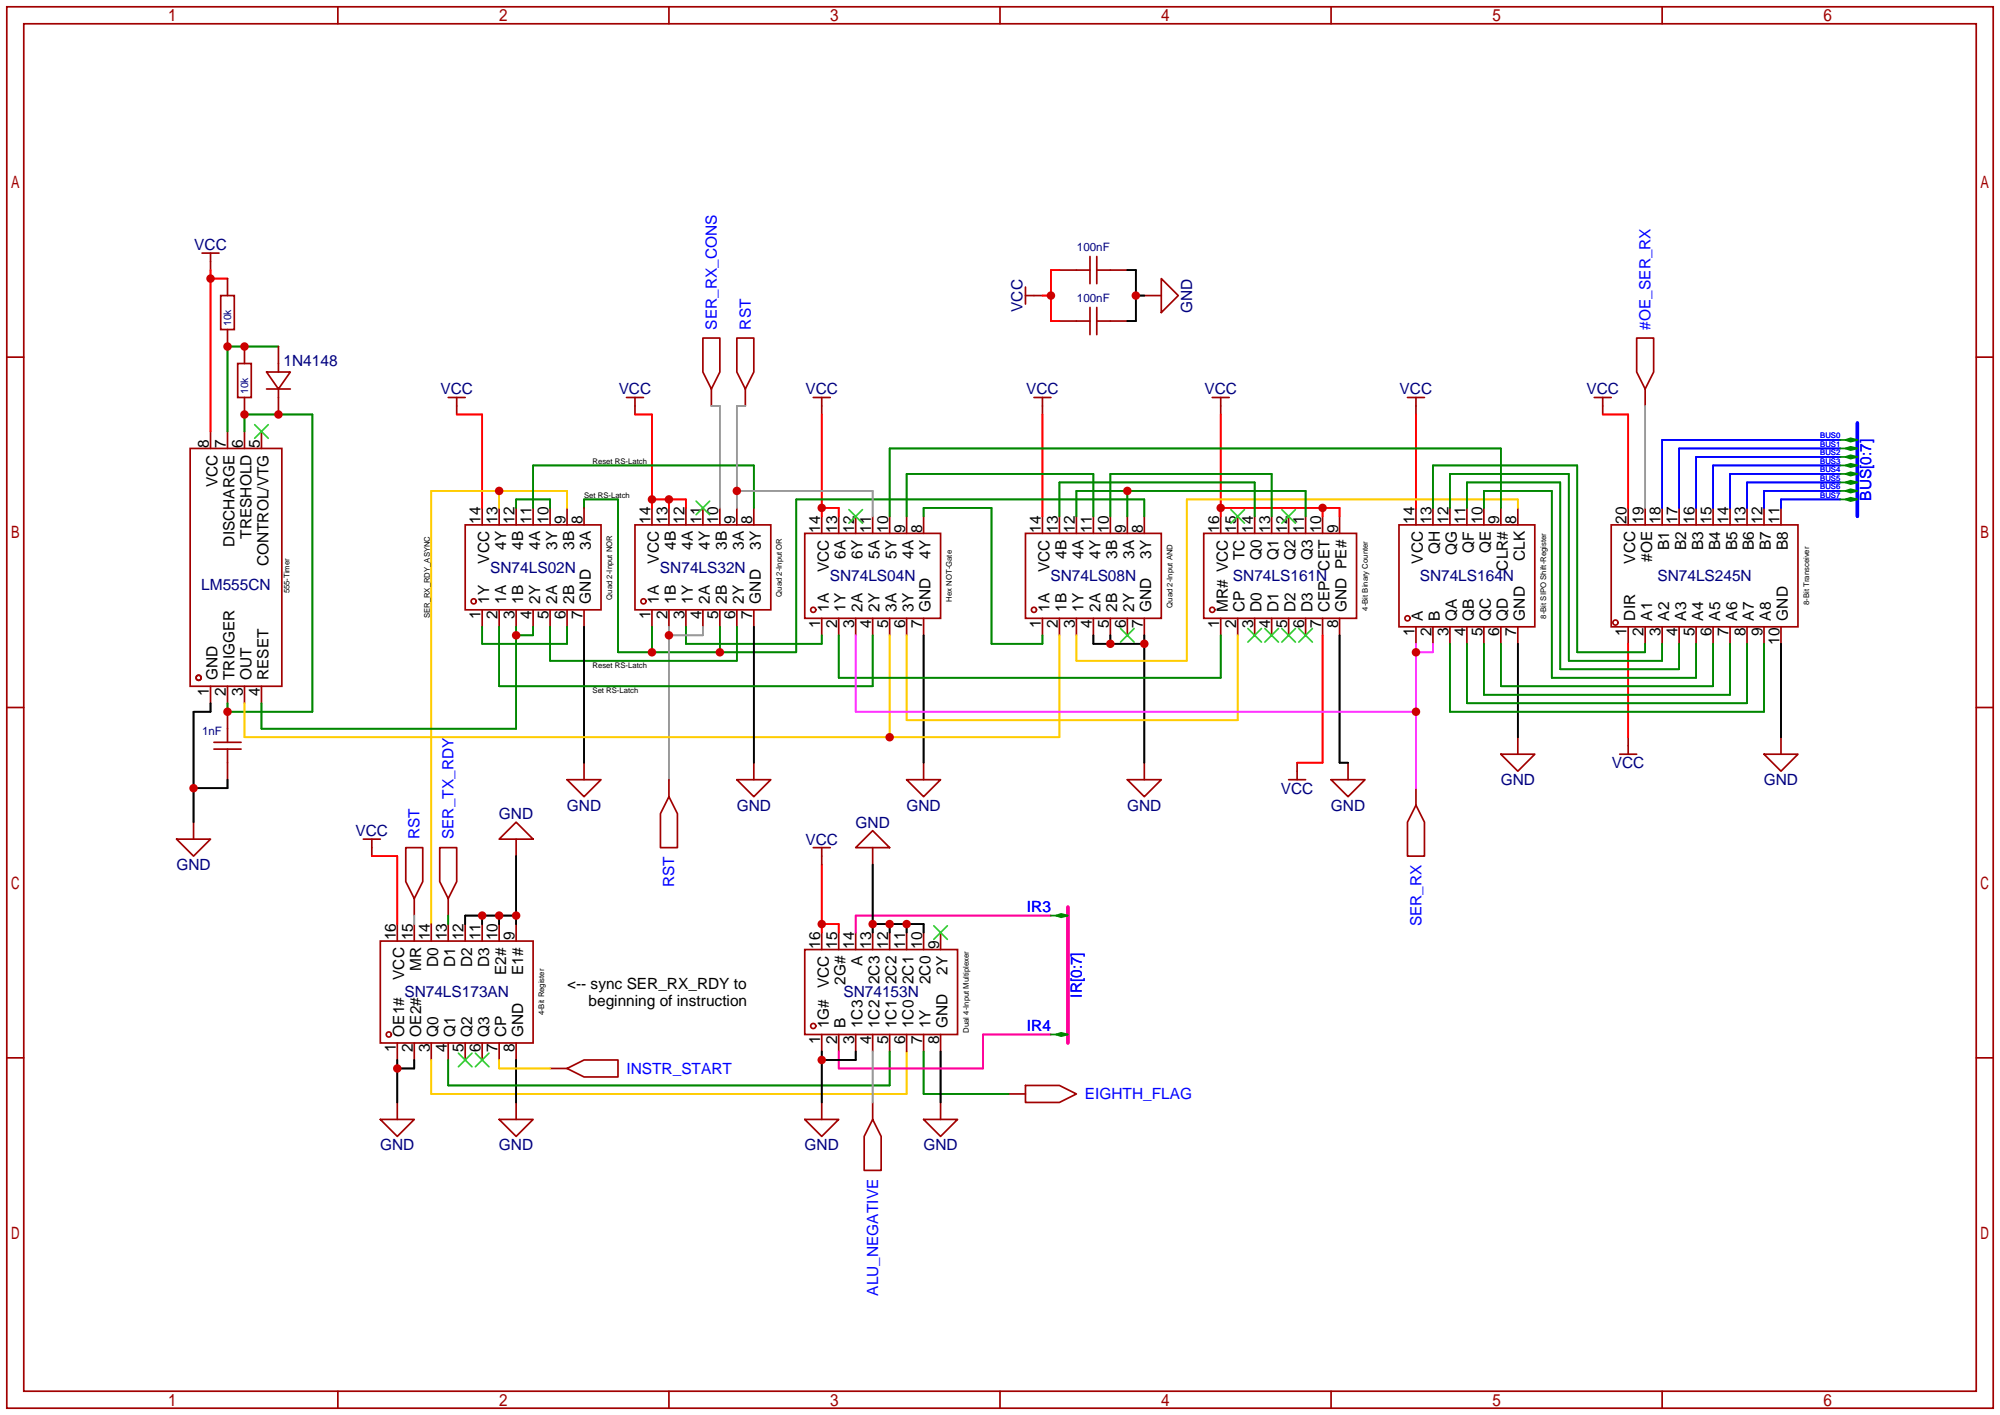
[picture p21: page 1]

9 QE 10 QF 11 QG 12 QH 13 VCC 14

8-Bit SIPO Shift-Register
