timbslr/8-Bit-Breadboard-Computer/Schematics/TMP-Register.pdf

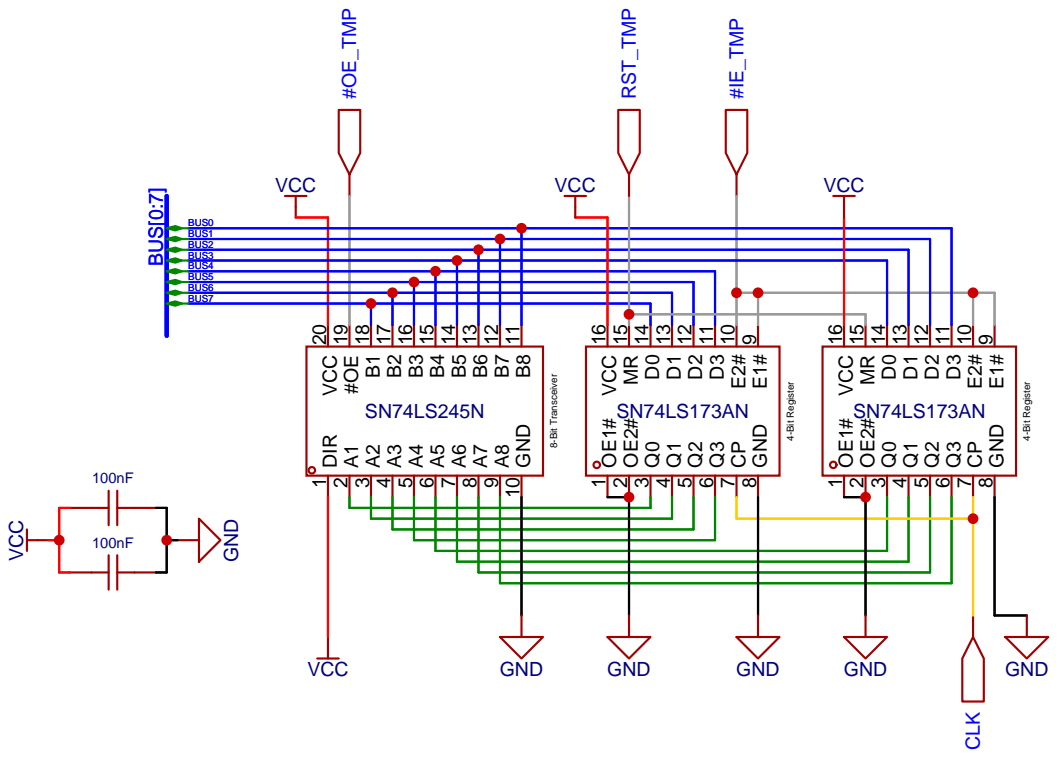
[picture p22: page 1]
