timbslr/8-Bit-Breadboard-Computer/Schematics/PRB-Register.pdf

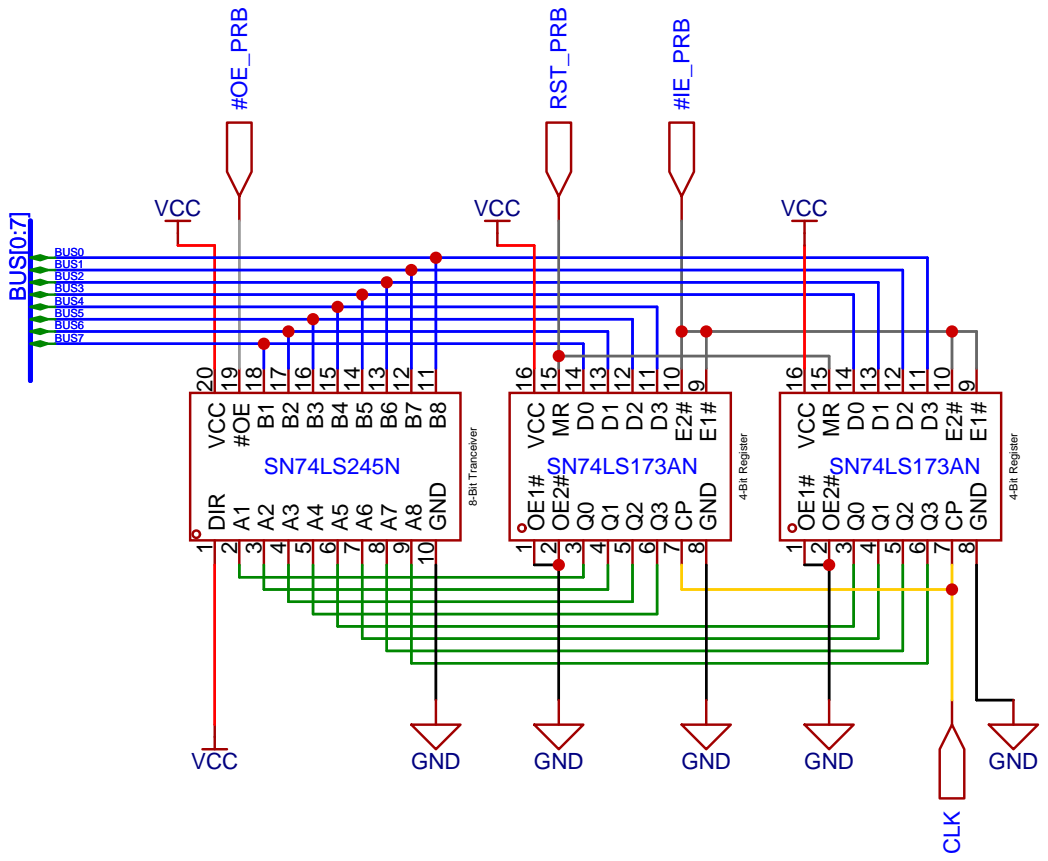
[picture p24: page 1]
