timbslr/8-Bit-Breadboard-Computer/Schematics/Program Counter.pdf

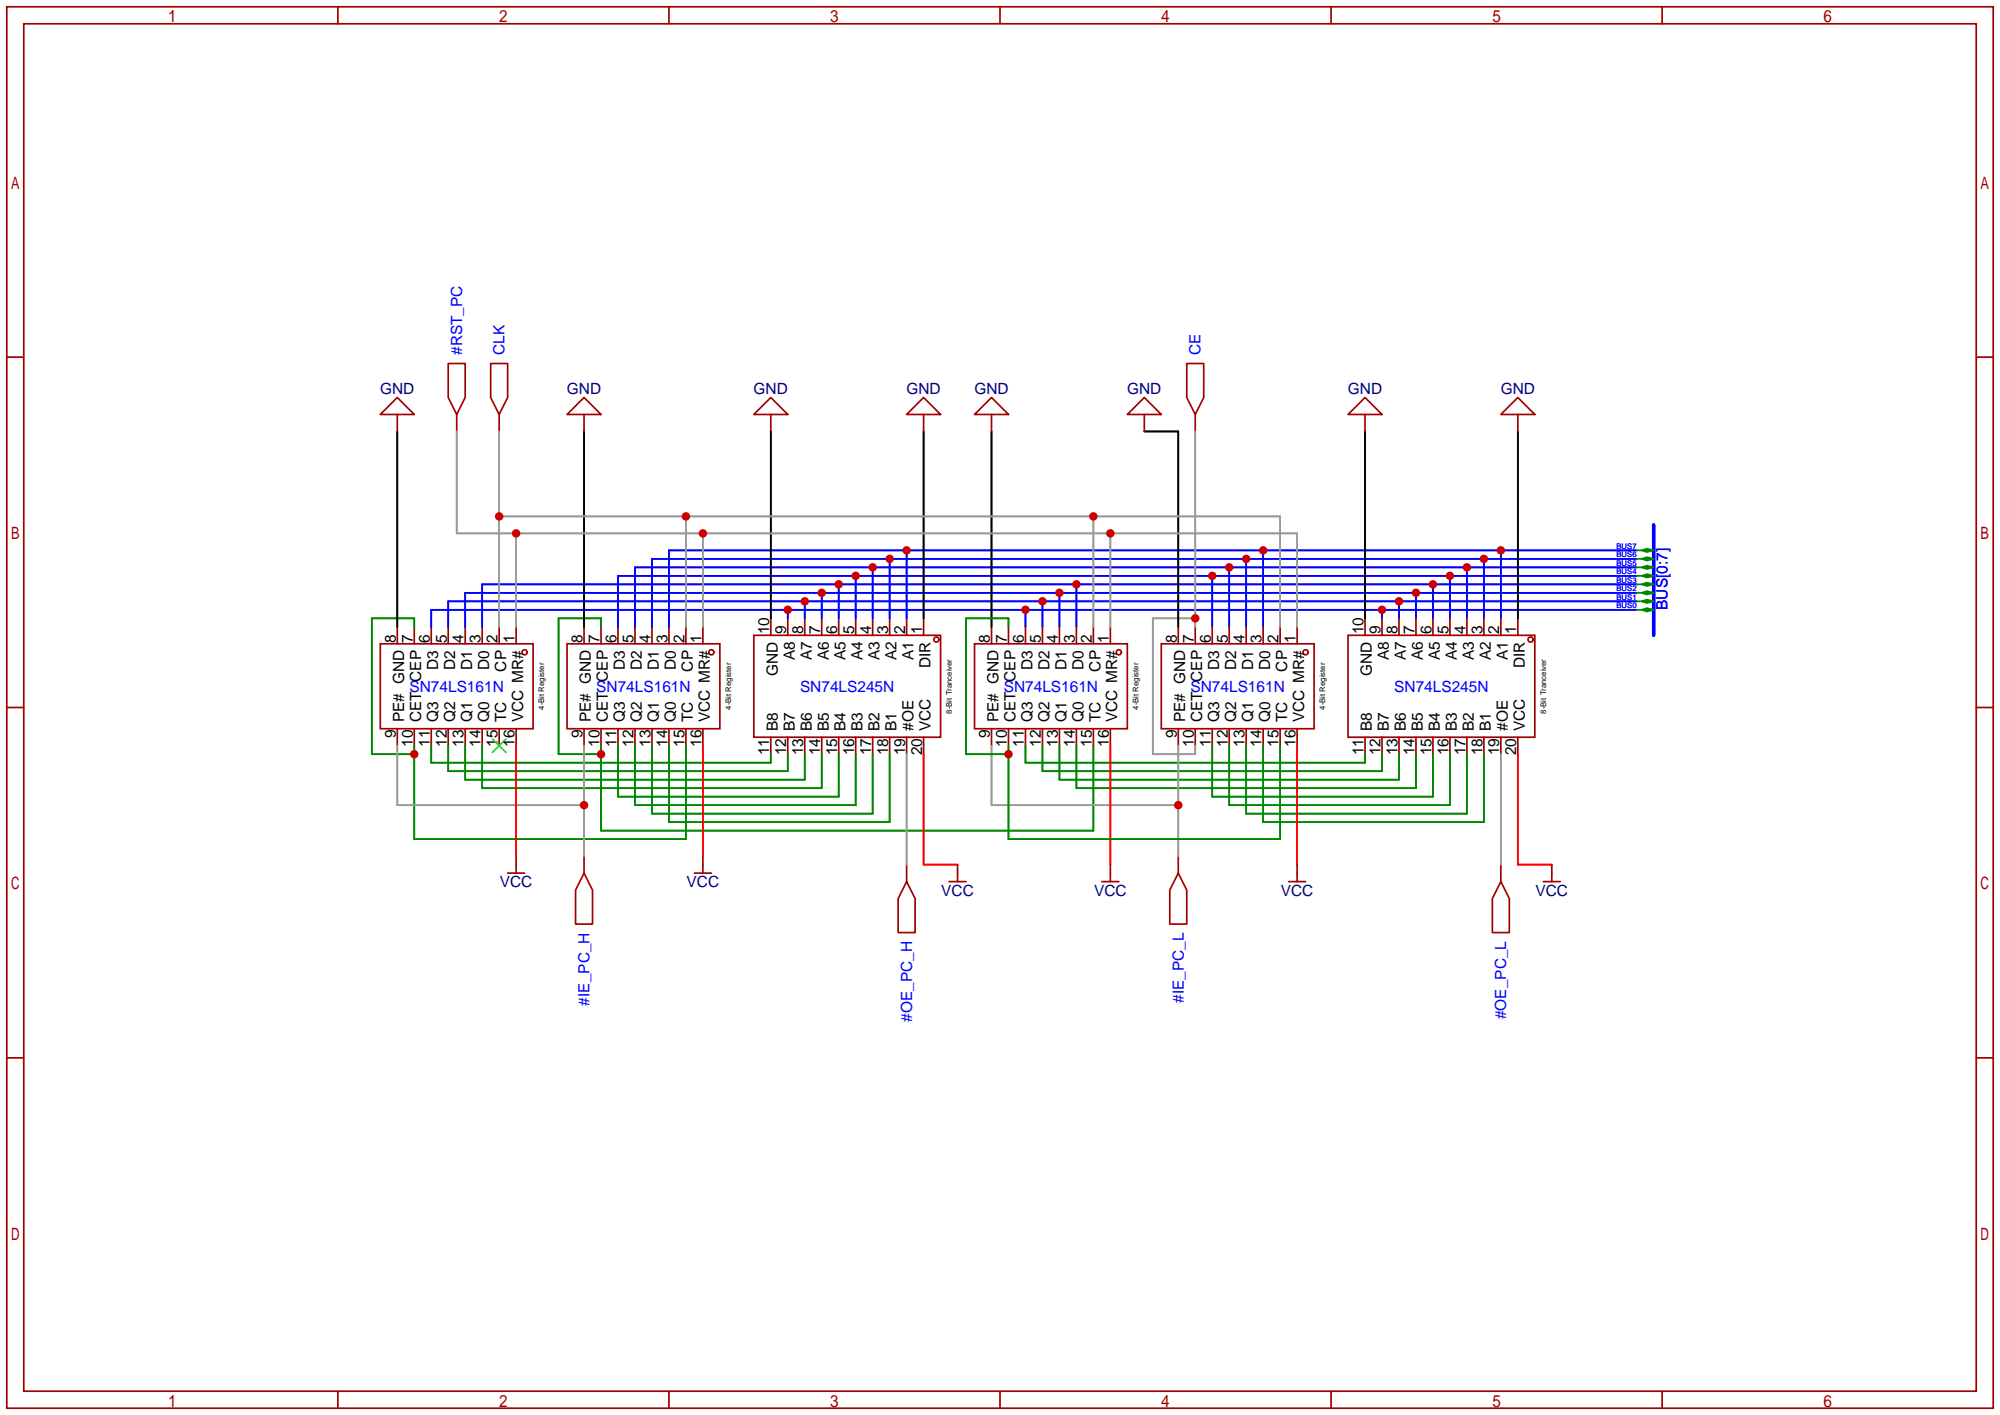
[picture p25: page 1]
