timbslr/8-Bit-Breadboard-Computer/(list of files, drawings)

Other design files:
Schematics/8-Bit Breadboard Computer Schematics.eprj
