timbslr/8-Bit-Breadboard-Computer/(commit log)

2025-08-09 uploaded schematics for the A-Register and the beginning of the Microarchitecture diagram
    [8-Bit Breadboard Computer Schematics.eprj]
2025-08-09 Added Schematics for the Program Counter
    [8-Bit Breadboard Computer Schematics.eprj]
2025-08-18 added ics to alu schematic, labelled ics, added generator for ALU EEPROMs
    [8-Bit Breadboard Computer Schematics.eprj]
2025-08-19 edited schematics
    [8-Bit Breadboard Computer Schematics.eprj]
2025-08-20 fixed line breaks in docs
    [8-Bit Breadboard Computer Schematics.eprj]
2025-08-20 added B-, C- and TMP-register to the schematics
    [8-Bit Breadboard Computer Schematics.eprj]
2025-08-30 Added Schematics for the ALU
    [8-Bit Breadboard Computer Schematics.eprj]
2025-08-30 Schematics: Added color to important wires
    [8-Bit Breadboard Computer Schematics.eprj]
2025-08-30 Schematics: Added ALU and Flags Register
    [8-Bit Breadboard Computer Schematics.eprj]
2025-08-30 Added PDF files for schematics
    [8-Bit Breadboard Computer Schematics.eprj]
2025-09-01 added a higher level overview for the alu schematic
    [8-Bit Breadboard Computer Schematics.eprj]
2025-09-06 renamed C-Register to X-Register for remembering convention
    [8-Bit Breadboard Computer Schematics.eprj]
2025-09-07 added overflow flag logic to schematics
    [8-Bit Breadboard Computer Schematics.eprj]
2025-09-08 Added Schematics for PRB-, IR-, Register, SP
    [8-Bit Breadboard Computer Schematics.eprj]
2025-09-10 X-Register: replaced normal registers with up/down counters => direct inc/dec is faster
    [8-Bit Breadboard Computer Schematics.eprj]
2025-09-13 docs: added resistor values to LEDs
2025-09-15 added schematics for 7-segment display
    [8-Bit Breadboard Computer Schematics.eprj]
2025-09-15 added schematics for MAR
    [8-Bit Breadboard Computer Schematics.eprj]
2025-09-16 added Memory to schematics
    [8-Bit Breadboard Computer Schematics.eprj]
2025-09-16 renamed MEM_DATA_DIR control bit to MEM_EN_IO
    [8-Bit Breadboard Computer Schematics.eprj]
2025-09-17 docs: added option to switch representation of the instruction set page
2025-09-19 changed overflow flag logic because i need the one SN74151AN I own for the controller
    [8-Bit Breadboard Computer Schematics.eprj]
2025-09-26 Added missing wires in ALU schematics
    [8-Bit Breadboard Computer Schematics.eprj]
2025-09-27 added schematics for Flags-Register and LCD-Display, corrected other schematics
    [8-Bit Breadboard Computer Schematics.eprj]
2025-09-27 renamed LCD-Display to LCD
    [8-Bit Breadboard Computer Schematics.eprj]
2025-09-29 schematics: added Controller and ALU operations table to overview
    [8-Bit Breadboard Computer Schematics.eprj]
2025-09-29 renamed "CE" to "INC_PC"
    [8-Bit Breadboard Computer Schematics.eprj]
2025-10-01 renamed PRB-Register to Buffer-Register
    [8-Bit Breadboard Computer Schematics.eprj]
2025-10-23 updated Schematics, esp. added monostable multivibrator to X-Register
    [8-Bit Breadboard Computer Schematics.eprj]
2025-10-25 added missing NC-symbols and schematic for controller
    [8-Bit Breadboard Computer Schematics.eprj]
2025-10-27 docs: added schematics to module pages, added pdf to svg converter for schematics
    [8-Bit Breadboard Computer Schematics.eprj]
2025-10-31 made bitwise ALU operations work, removed rorn and roln for n=0
    [8-Bit Breadboard Computer Schematics.eprj]
2025-11-02 made lcd work
    [8-Bit Breadboard Computer Schematics.eprj]
2025-11-02 removed ALU Operations Table from Hardware Overview
    [8-Bit Breadboard Computer Schematics.eprj]
2025-11-21 fixed occasional incrementing or decrementing of the X-Register with a low-pass filter
    [8-Bit Breadboard Computer Schematics.eprj]
2025-11-26 added two instructions for switching 7-Segment Display mode
    [8-Bit Breadboard Computer Schematics.eprj]
2025-11-26 added reset logic to 7-Segment Display mode-selector
    [8-Bit Breadboard Computer Schematics.eprj]
2025-11-28 made description for TMP-Register consistent to "TMP" (renamed partly "T" to "TMP")
    [8-Bit Breadboard Computer Schematics.eprj]
2025-11-28 removed bit instruction as it is not fully implementable with the current hardware
2025-11-29 added parts list for each module
    [7-Segment Display.csv, 8-Bit Breadboard Computer Schematics.eprj, A-Register.csv, ALU.csv, B-Register.csv, BUF-Register.csv, Controller.csv, Flags-Register.csv]
2025-11-29 docs: added complete parts list
    [7-Segment Display.csv, 8-Bit Breadboard Computer Schematics.eprj, General.csv]
2025-11-29 fixed typo in word "transceiver"
    [8-Bit Breadboard Computer Schematics.eprj, A-Register.csv, ALU.csv, B-Register.csv, BUF-Register.csv, IR.csv, LCD.csv, Memory.csv]
2025-11-29 removed red line at the top of the ALU svg that didn't belong there
    [8-Bit Breadboard Computer Schematics.eprj]
2025-12-03 added hlt instruction, docs: added schematics and module pages for Reset and Clock
    [8-Bit Breadboard Computer Schematics.eprj, Clock.csv, Controller.csv, Reset.csv]
2025-12-07 implemented lcdrd instruction, so that the lcd also works with 1Mhz, adjusted example codes
    [8-Bit Breadboard Computer Schematics.eprj, Controller.csv]
2025-12-09 added sorting to PartLists
    [7-Segment Display.csv, 8-Bit Breadboard Computer Schematics.eprj, General.csv]
2025-12-18 added consistent naming scheme for PartList (instead of partially "BOM"), reformatted files to wider printWidth
    [7-Segment Display.csv, A-Register.csv, ALU.csv, B-Register.csv, BUF-Register.csv, Clock.csv, Controller.csv, Flags-Register.csv]
2025-12-21 added receive part of the Serial Interface (not fully completed yet)
    [8-Bit Breadboard Computer Schematics.eprj, Serial Interface.csv]
2025-12-23 Schematics: made gray-tones consistent
    [8-Bit Breadboard Computer Schematics.eprj]
2025-12-30 Schematics: fixed short in Controller
    [8-Bit Breadboard Computer Schematics.eprj]
2026-01-02 finished schematic for the Receiver of the Serial Interface
    [8-Bit Breadboard Computer Schematics.eprj, Serial Interface Receiver.csv, Serial Interface.csv]
2026-01-03 improved Serial Interface Receiver schematic for breadboard build
    [8-Bit Breadboard Computer Schematics.eprj, Serial Interface Receiver.csv]
2026-01-15 implemented Receiver of the Serial Interface
    [8-Bit Breadboard Computer Schematics.eprj, Controller.csv, Serial Interface Receiver.csv]
2026-01-25 started refactoring the docs autogeneration code, mostly everything related to "Instruction"
    [8-Bit Breadboard Computer Schematics.eprj]
2026-02-08 started implementing the serial transmitter
    [8-Bit Breadboard Computer Schematics.eprj, Serial Interface Receiver.csv, Serial Interface.csv]
2026-02-08 started documenting the controller (and fixed a label in the schematics)
    [8-Bit Breadboard Computer Schematics.eprj, Controller.csv]
2026-02-14 made the Serial Transmitter work at 1Mhz
    [8-Bit Breadboard Computer Schematics.eprj, General.csv, Serial Interface.csv]
2026-02-14 updated overview diagram
    [8-Bit Breadboard Computer Schematics.eprj]
2026-02-17 removed unnecessary decoder in X-Register
    [8-Bit Breadboard Computer Schematics.eprj, X-Register.csv]
2026-02-20 added hardware support for Y-Register, added inc/dec support for SP
    [8-Bit Breadboard Computer Schematics.eprj]
2026-02-28 implemented RST_TMP in hardware
    [8-Bit Breadboard Computer Schematics.eprj, Controller.csv]
2026-03-05 added Y- and C-Register in documentation
    [8-Bit Breadboard Computer Schematics.eprj, C-Register.csv, X-Register.csv, Y-Register.csv]
2026-03-12 updated hardware for the Stack Pointer
    [SP.csv]
2026-03-13 removed unnecessary label in schematics
2026-03-18 reduced size of rules.asm by letting the assembler choose the correct rule instantiation
2026-03-25 added Arduino script for displaying the currently execute instruction
2026-03-30 updated schematics
    [Controller.csv]
2026-03-30 updated Y-Register schematic
2026-03-31 debounced Reset-Button
    [Reset.csv]
2026-04-02 updated Arduino Mnemonic Display sketch
2026-04-18 moved INC_PC to its own controller pin as the previous configuration caused rare timing issues/a race condition
    [Controller.csv]
2026-05-09 fixed MAR data direction in the hardware overview diagram
    [8-Bit Breadboard Computer Schematics.eprj]
2026-09-01 fixed some things in the ISA and the schematics
    [8-Bit Breadboard Computer Schematics.eprj]
2026-09-07 made clear that ldsprel and stsprel are unsigned, changes resistor value of yellow leds
    [General.csv]
2026-09-17 added instructions: addispu and subispu
    [8-Bit Breadboard Computer Schematics.eprj]
2026-09-18 updated SP schematics and the mnemonic display script
    [8-Bit Breadboard Computer Schematics.eprj, SP.csv]
2026-09-23 made every invalid opcode halt, changed ruleGenerator to support new customasm function syntax
    [8-Bit Breadboard Computer Schematics.eprj]
2026-10-01 added ESP32 IR history debug script, fitted inc/dec pins to new wiring
    [8-Bit Breadboard Computer Schematics.eprj]
